ea4iln-debug/CHISPAS-EA4ILN/ROADMAP.md

# Hoja de ruta de Chispas

Estado a 16 de octubre de 2026, con el firmware **v1.20** (final; la v1.10 fue la primera final). Lo marcado ✅ está hecho y probado en placa.

## 1. Pruebas pendientes

Funciones que ya están en el firmware pero falta comprobar en la placa.

| | Prueba | Cómo |
|---|---|---|
| ✅ | Reinicio de la OTA si la descarga no avanza en 30 s | 16 oct 2026, placa 2: internet cortado al 40 %, reinicio a los 30 s en la v1.10 |
| ⬜ | Tendencia del BME280 y aviso de tormenta | Placa 1 con varias horas de datos |
| ✅ | Parques POTA cercanos con fijo del GPS | 15 oct 2026, en la calle con la posición del GPS |
| ✅ | Pila del motor CW tras Duo | 15 oct 2026 (v1.10): 3148 bytes libres de 4096 |
| ✅ | QSO LIBRE en los dos sentidos | 15 oct 2026, placa perforada y protoboard |
| ✅ | Batería calibrada con polímetro | 15 oct 2026, placa perforada: factor único 4,985 para todas |
| ~~⬜~~ | ~~Consumo del GPS dormido~~ | Descartado el 16 oct 2026: despreciable, no se mide |
| ~~⬜~~ | ~~Nube de tormenta del salvapantallas~~ | Descartado el 16 oct 2026: en Badajoz hay pocas tormentas (la cara de auriculares, vista) |
| ⬜ | Salvapantallas y brillo (v1.05b) | Cara a los 15 s en Inicio, PROP, POTA, SOL y CONF (no en CW, LoRa, TRX ni con el portal/QR); brillo tenue al minuto en todas |
| ✅ | Control del amplificador (SD en GPIO38) | Placa 1, 12 oct 2026 (v1.04b por OTA): suena en CW, LoRa, TRX y el pitido de TONO; calla en el resto |
| ✅ | Estabilidad tras muchas horas | Placa 2, noche del 12 oct 2026: 8 h en POTA (233 consultas HTTPS); heap libre ±150 B, mínimo estable tras la 1.ª hora, mayor bloque y pilas sin cambios |
| ✅ | OTA del binario sin encoder a la v1.02b y a la v1.03b | Placa 2, 12 oct 2026 (la variante se quitó en la 1.20) |
| ✅ | Batería después del decodificador | Placa 2, 12 oct 2026: la tensión se sigue leyendo bien tras DECODIFICAR y QSO |
| ✅ | QSO del TRX con emisora real | 12 oct 2026: manipular y decodificar en la misma sesión, sin descodificar lo propio |
| ✅ | Keyer iámbico | 12 oct 2026: apretón en modo A y B, y textos largos |
| ✅ | Xiegu X6200 con KEY | 12 oct 2026, en llave recta con el puente R-T de J4: TUNE, palas y memorias |
| ✅ | Dormir y despertar en la placa 1 | 12 oct 2026 (antes solo en la placa 2) |
| ✅ | Consumo en deep sleep | Despreciable, medido en µA (12 oct 2026) |

## 2. Hardware

### Montado
- **GPS NEO-6M**: ✅ montado y probado el 13 oct 2026 (TX a GPIO47, RX a GPIO39). Apagarlo cuando no se usa:
  1. ✅ **Por software (funciona; consumo dormido despreciable, no se mide):** cable de GPIO39 (J3-10) al RX del GPS y órdenes UBX (`UBX-RXM-PMREQ` para
     dormir; si no despierta bien, `UBX-CFG-RST` con GNSS stop/start). Medir con el polímetro en serie con el VCC del
     GPS: si dormido baja de ~0,5 mA, no hace falta transistor.
  2. ~~Interruptor en el positivo~~ (**descartado el 13 oct 2026**; GPIO3, BAJO = encendido): AO3401A, o sus equivalentes en SOT-23 IRLML6401,
     Si2301 o DMG2305UX, con R8 de 100 kΩ; o un PNP de patillas (BC327 o BC557) con 1 kΩ en la base y 10 kΩ de base a
     emisor, que resta ~0,1–0,2 V. No valen el BSS84 ni el BS250 (no conducen bien con 3,3 V).

### Por comprar
- Divisor de minijack 1 → 2, para seguir oyendo la emisora con el decodificador conectado.

### Opcional
- **Trafo de aislamiento 600:600**, solo si aparece zumbido por lazo de masa con la emisora.
- **C3 (10–100 nF) de GPIO6 a GND**, solo si el decodificador da ruido o letras falsas (por ejemplo, al transmitir
  con potencia): filtra la RF y el ruido de alta frecuencia y estabiliza la lectura del ADC.
- **Detección de USB y de carga** (aparcada el 14 oct 2026): sin USB el pin 5V da 1,3 V, no 0 V, y con 47k/68k a
  GPIO33 quedan 0,7 V, poco margen. Si se retoma, GPIO3 con ADC (ver NOTAS).

### PCB propia (en curso)
- ✅ Placa perforada montada y probada (15 oct 2026).
- ✅ PCB en KiCad 10 (90 × 60 mm, SMD montado por JLCPCB): esquema, rutado y serigrafía; pedidos a JLCPCB (5 placas)
  y LCSC hechos el 15 oct 2026.
- ⬜ Recibir, montar y probar (comprobar el encaje del potenciómetro CTR comprado para R7, en lugar del ALPS
  sin stock; el diseño y la BOM siguen con el ALPS).

## 3. Desarrollo del firmware

### Con el hardware nuevo
- ✅ **GPS en el firmware (hecho y probado en la placa 1 el 13 oct 2026**; detalle en NOTAS, "Funciones"; añadido:
  CONFIG > HORA (UTC/LOCAL) y RELOJ (fuente GPS > WIFI > MANUAL y hora a mano). Diseño con el que se hizo:
  - **Estados:** AUSENTE (sin módulo: todo como hoy) · DORMIDO (por defecto) · BUSCANDO · CON FIJO. Se despierta solo
    cuando algo necesita un dato y vuelve a dormir al tenerlo; mientras, se usa el último dato bueno.
  - **Cuándo se despierta:** al arrancar o despertar Chispas (antes un 0xFF por si quedó dormido de la sesión anterior:
    sigue alimentado aunque el ESP32 se reinicie; tope ~5 min sin fijo); **cada 10 min**, con la muestra de presión del
    BME280 (tope ~60 s); **mientras se ve STATUS > GPS**; antes del deep sleep, PMREQ y GPIO39 retenido en ALTO
    (reposo de la UART). Consumo medio estimado ~2 mA (razonado).
  - **Hora:** UTC del GPS en el reloj del sistema; SOL ya no enciende el WiFi si hay hora del GPS (NTP sin GPS).
  - **Locator:** CONFIG > LOCATOR con opción **AUTO (GPS)** / manual; el manual queda de respaldo. Guardar en NVS solo si
    cambia la cuadrícula.
  - **Altitud y BME280:** QNH recalibrado con la media de la altitud del GPS; historial de presión **corregido a nivel
    del mar** con la altitud de cada muestra (sin falsos "TORM!" al subir: 3 hPa son solo ~25 m).
  - **STATUS > GPS** (página nueva): estado, satélites en uso, lat/lon, altitud, HDOP, locator y antigüedad del dato;
    "GPS NO DETECTADO" sin módulo.
- ✅ **Parques POTA cercanos (hecho el 14 oct 2026, en POTA > VER PARQUES):** lista de parques de España descargada de pota.app a la placa con WiFi
  (LittleFS, partición de 1,5 MB reservada; **no** en el repositorio) y búsqueda sin conexión: los más cercanos con
  distancia y rumbo en la pantalla POTA; "ACTUALIZAR PARQUES" con WiFi. Antes: leer las condiciones de uso de los datos
  de POTA y averiguar la URL de la lista o de la búsqueda por zona.
- **BME280, lo que queda** (lo básico está hecho en la v1.03b):
  - Comprobar la tendencia y el aviso de tormenta con datos de varias horas.
  - ✅ Con el GPS (v1.07b): QNH calibrado con la altitud del GPS e historial de presión a nivel del mar (sin falsos
    avisos de tormenta al subir a un monte).
  - Por decidir: mantener el historial de presión con Chispas dormido (despertar cada 15 min).

### Ideas decididas
- ✅ **POTA sin conexión** (14 oct 2026): lista de parques de España en LittleFS y los más cercanos en POTA > VER
  PARQUES. Queda, si se quiere, buscar un parque por referencia.
- ✅ **Autospot POTA** (18 oct 2026): VER PARQUES > pulsar > ficha > enviar, con aviso a los 25 min para renovarlo.
  Queda, si se quiere, la **cola**: guardar el spot sin cobertura y enviarlo en cuanto haya WiFi (ojo: un spot
  atrasado puede engañar a los cazadores). La frecuencia, sin CAT, se mete a mano (ver CAT abajo).
- ✅ **Batería en `[DIAG]`** (16 oct 2026): `| BAT 4.17V 100%` al final de la línea, para medir la autonomía con un registro.
- ✅ **Koch con indicativos y QSO POTA** (16 oct 2026): ajuste TEXTO del Koch.
- ✅ **Ritmo de la manipulación** (16 oct 2026): TX LIBRE > menu > RITMO. Falta probarlo con las palas.
- **CLUSTER** (23 oct 2026, en diseño): pantalla 10 con spots por telnet (RBN por defecto, URE y otros), lista,
  ficha, "a SU" y ¿QUIÉN ME OYE? (fase 1); alertas (fase 2); enviar spots (fase 3). Nodos y decisiones en NOTAS: "CLUSTER".

### Por decidir
- ✅ **Batería llena = 100 %** (16 oct 2026): 4,15 V o más cuenta como 100 %.
- ~~**SOTA**~~ (**descartado**): las condiciones de su API exigen aprobación previa para software generado con IA;
  no se programa el cliente.

### A estudiar (no prioritario)
- **Audio I2S:** tono senoidal con rampas (sin clics) y volumen por software con un módulo DAC + amplificador I2S
  (p. ej. MAX98357A, 3 GPIO). Sustituiría al PAM8302A y obligaría a rehacer la salida de auriculares.
- **GPS ATGM336H** en lugar del NEO-6M: más pequeño, más barato y de menor consumo (GPS + BeiDou), con la misma
  conexión (UART a 9600 bd, NMEA). Por ahora se sigue con el NEO-6M.
- **Despertar y pitar a distancia ("buscar Chispas")** (16 oct 2026, aparcado): el deep sleep apaga la radio, así
  que el BLE no puede despertar. Opciones: light sleep con BLE anunciándose (~1–3 mA dormido; NimBLE; ajuste
  apagado por defecto; Web Bluetooth desde la web en Chrome, no en iPhone), deep sleep con despertar periódico, o
  despertar por LoRa (`startReceiveDutyCycle`, DIO1 = GPIO14 RTC; mucho menos consumo, pero solo desde otro
  Chispas). Primer paso: medir el consumo en light sleep con BLE en una prueba aparte en `pruebas/`.
- **Navegación en el campo con el GPS** (18 oct 2026, aparcado hasta una PCB nueva): marcar el punto de partida, ir
  a un parque POTA (rumbo y distancia), grabar el recorrido en LittleFS (12 bytes por punto) y volver en línea recta
  o desandando. Aparcado porque **sin brújula** el NEO-6M solo da el rumbo de marcha (inútil parado o a menos de
  ~3 km/h); hace falta magnetómetro y acelerómetro (compensar la inclinación) en una futura versión de la PCB, p. ej.
  en Wire1 con el BME280. Consumo estimado: GPS siempre despierto, ~70 mA, unas 40 h con 3000 mAh (frente a ~100 h).
- **CAT con el transceptor** (18 oct 2026, aparcado hasta una PCB nueva): leer la frecuencia y el modo (para el
  autospot POTA y TRX), QSY a un spot con un clic. Radios del usuario: **Icom CI-V** (IC-705, 7300…; un hilo, jack
  de 3,5 mm) y **FT-817/818** (serie TTL a 5 V por ACC, mini-DIN 8), y quizá otra por concretar. Un conector CAT de
  3 hilos (TX, RX, GND) en el UART2 con dos pines libres (33, 34, 40 o 3): CI-V uniendo TX y RX con diodo y pull-up,
  FT-817 con divisor de 5 a 3,3 V en la RX; tipo por puente o en CONF > CAT (NO / ICOM / FT-817, dirección CI-V,
  velocidad). Software: un `cat.inc` (~200 líneas por protocolo; CI-V `0x03`, FT-817 trama de 5 bytes). Radios
  **solo USB** (FT-891, QMX…): no viables, el USB del S3 (GPIO19/20) lo usa el encoder. Con la PCB actual se puede
  probar con cables a los pines libres.

### Instalación y estructura del firmware (ideas)
- ~~**Web de instalación por USB**~~ **Hecha el 16 oct 2026**: https://ea4iln-debug.github.io/CHISPAS-EA4ILN/
  (ESP Web Tools en GitHub Pages; una GitHub Action copia y parte el firmware de la última release final para
  conservar la NVS). Detalle en `docs/NOTAS.md` ("Releases y OTA").
- **Firmware modular**, con la opción de **un solo binario con todo y módulos activados en el aparato** (la app ocupa
  bastante menos de la mitad de sus 3,2 MB): autodetección donde se pueda (el BME280 ya se detecta; el GPS, si llegan
  frases NMEA) y una pantalla **CONF > HARDWARE** (o un asistente al primer arranque) para lo que no se detecta
  (encoder, amplificador, KEY…). Un solo binario simplifica la OTA (la variante sin encoder ya se quitó en la 1.20). La
  web podría llevar casillas de hardware (generando la NVS en el navegador, o mejor preguntándolo al primer arranque).
  Descartado: compilar a la carta en un servidor (lento, necesita un token o un servidor propio) y precompilar todas
  las combinaciones (2^N binarios).
- **Partir `main.cpp` en módulos** (keyer, Koch, Echo, LoRa, TRX, decodificador, WiFi, BME, GPS…) con su `.h`/`.cpp`
  y una interfaz común de disponible/activado; por fases, sin cambiar el comportamiento, compilando y probando en
  placa en cada paso. Prepara el Lite (LoRa o ESP-NOW como transporte intercambiable). Paso previo hecho el 13 oct
  2026: `main.cpp` ya está repartido en `src/parts/*.inc` (mismo código, una sola unidad de compilación).

## Versiones de Chispas (ideas)

### Chispas Pro (el actual, Heltec V3)
- **Bluetooth (BLE)**: el ESP32-S3 solo tiene BLE 5 (nada de auriculares Bluetooth ni puerto serie clásico).
  - **Teclado Bluetooth (HID):** lo manipulado con las palas se escribe en el móvil o el PC; con las teclas que espera
    **VBand**, practicar por internet con las palas, sin cables.
  - **Configuración y estadísticas desde el móvil** con una página **Web Bluetooth** (Chrome, sin instalar nada):
    memorias, indicativo y locator; estadísticas de Koch y Echo con gráficas y exportación.
  - **Hora y posición del móvil** para SOL y la línea gris en el campo, sin WiFi ni GPS.
  - **El móvil como pasarela** en una salida POTA: spots y propagación hacia Chispas, y publicar el spot propio.
  - **Teclado CW desde el móvil** (diseñado el 13 oct 2026, por decidir): servicio **Nordic UART (NUS)** por BLE,
    usable con apps ya existentes (*Serial Bluetooth Terminal* en Android; *Bluefruit Connect* o *nRF Connect*, también
    en iPhone). Opción BLUETOOTH en CONFIG, nombre `Chispas-XXXX` e indicador **BT** en la cabecera. Lo escrito sale
    según la pantalla: por **KEY** en TRX > OPERAR/QSO (a los wpm de TRX, como una memoria), por **LoRa** en QSO LIBRE,
    y por el **altavoz** en TX LIBRE; en el resto se ignora. `{MI}`, `{SU}` y `{WX}`; cola de ~200 caracteres; las
    palas o `/stop` lo cortan; órdenes opcionales (`/wpm 25`, `/su EA1ABC`, `/m1`). Chispas devuelve al móvil lo
    enviado y lo descodificado en TRX > QSO (registro del QSO). Solo transmite por KEY donde ya lo hace y con el corte
    de 10 s. Trabajo: NimBLE + NUS (~200–300 líneas), cola hacia el motor CW (trozos de 64) o QSO LIBRE; antes, medir
    la memoria con BLE y WiFi a la vez. Empezar por TRX y TX LIBRE.
  - Coste: unos 50–100 KB de RAM (hay ~249 KB libres), algo de flash y de consumo; mejor NimBLE que Bluedroid
    (comprobar con el core 2.0.17 y el S3).
- **Carcasa impresa en 3D con diseño propio:** OpenSCAD paramétrico a partir del plano de la placa perforada
  (`docs/gen_placa.py`); logo de chispa, «CHISPAS EA4ILN» en relieve, rejilla del altavoz con «73» en Morse y rótulos
  grabados junto a los jacks. Faltan las medidas de batería, altavoz, jacks, encoder, RV1, GPS, interruptor y SMA, el
  uso (mesa, mano o colgado) y el estilo. Probar por piezas antes de imprimir la caja entera.

### Chispas Ultimate
- **Palas táctiles integradas** (como el Morserino-32): GPIO4 y GPIO5 son táctiles en el S3; el jack de palas pasaría
  a GPIO39/40. Electrodos: tornillos de latón o inoxidable, chapa, trozos de PCB dorada, cinta de cobre por dentro de
  la pared o filamento conductor; 470 Ω–2 kΩ en serie. Firmware: `touchRead()` en la tarea del keyer, calibración al
  arrancar y sensibilidad en CONF. Pegas: humedad, guantes, sensibilidad según se sujete. Prueba previa barata: un
  programa en `pruebas/` con dos tornillos o cinta de cobre.

### Chispas Lite
Un ESP32 cualquiera con OLED, encoder, palas y tono, **sin LoRa**. Hace casi todo lo del Pro; lo que pierde es el
alcance de la radio.
- **Igual que en el Pro** (no dependen de la LoRa): Koch (los dos modos de corrección, estadísticas y refuerzo), Echo,
  TX LIBRE (keyer A/B); PROP, POTA y SOL con NTP; webconf con QR; OTA (con sus propios binarios); CONF, STATUS,
  depuración, salvapantallas y dormir; TRX con KEY por PC817, memorias y TUNE.
- **Duo y QSO por ESP-NOW** (el WiFi del chip, sin router), con las mismas tramas: 50–200 m (más con línea de vista y
  el modo de largo alcance) frente a los kilómetros de la LoRa. **El Pro también tiene WiFi: podría hablar ESP-NOW y
  practicar con un Lite.** ESP-NOW y WiFi comparten radio y canal: durante Duo o QSO no se usa el WiFi (como ahora).
- **Según la placa:**
  - Decodificador: el ADC por DMA está escrito para el S3; en un ESP32 clásico o un C3 hay que adaptar la captura
    (el Goertzel y el resto sirven).
  - Batería: muchas placas no traen cargador ni divisor; añadir un TP4056 y un divisor.
  - Bluetooth: un ESP32 **clásico** tiene Bluetooth clásico además de BLE; se podría estudiar sacar el tono a
    auriculares Bluetooth (A2DP), que el S3 no puede. Experimental.
  - BME280, GPS y amplificador: opcionales, igual que en el Pro, si hay pines.
- **No tendría:** LoRa (ni largo alcance ni Duo/QSO por radio con un Pro lejano) ni OLED integrada, salvo placa que la
  traiga.
- **Coste:** la Heltec V3 cuesta unos 20–25 €; un ESP32 con OLED, encoder y cargador, unos 12–15 €. El ahorro está más
  en lo que se deja fuera (LoRa, GPS, BME280, amplificador) que en la placa: el Lite tiene sentido como versión más
  sencilla y barata para clubes o alumnos.
- **Firmware:** el mismo `main.cpp` con un entorno `chispas_lite` (como el antiguo `heltec_sin_encoder`); lo principal, separar
  la capa de transporte (LoRa / ESP-NOW), ya decidida como intercambiable.

## 4. Documentación y publicación
- ✅ GPS en el esquema (montado) y en el README; release v1.07b publicada (14 oct 2026).
- ✅ Capturas nuevas: CONFIG, STATUS > GPS, PONER HORA, POTA y VER PARQUES.
- ✅ Releases v1.08b y v1.09b (14 oct 2026), **v1.10** (15 oct 2026, primera final; última con binario sin encoder)
  y **v1.20** (16 oct 2026, solo con encoder).

## Orden propuesto
1. **Sin piezas:** tendencia del BME280 con varias horas de datos; salvapantallas y brillo (v1.05b).
2. **Al llegar la PCB:** montarla y probarla.
3. **Después:** cola de spots POTA y, si se quiere, Bluetooth (teclado CW desde el móvil).

## Hecho
- ✅ Entrenador Koch estilo LCWO con corrección por letra o por total, Echo y TX libre (keyer iámbico A/B).
- ✅ Estadísticas por carácter y por lección (Koch y Echo), y refuerzo de las letras con más errores.
- ✅ Práctica en pareja y QSO libre por LoRa.
- ✅ Tono por altavoz (amplificador PAM8302A) y auriculares, con volumen; SD del amplificador en GPIO38 desde la
  v1.04b. El buzzer piezo del principio sonaba demasiado bajo y se descartó.
- ✅ Salida KEY aislada con tune y memorias (probada con una uSDR).
- ✅ Decodificador CW del audio de la emisora (probado con audio Morse real).
- ✅ Propagación, spots POTA, sol y línea gris.
- ✅ Configuración en el aparato, página de estado y depuración desde el menú.
- ✅ Sensor ambiental BME280 (v1.03b): página AMBIENTE en SOL, tendencia y aviso de tormenta, altitud barométrica
  calibrable y macro {WX}.
- ✅ Actualización por WiFi desde las releases de GitHub.
- ✅ GPS (13 oct 2026): hora, locator y altitud automáticos; hora con fuente (GPS > WIFI > MANUAL) y puesta a mano.
- ✅ Parques POTA cercanos sin conexión (14 oct 2026): lista de España en LittleFS, distancia y rumbo.
- ✅ Consumo en reposo despreciable.
- ✅ Placa perforada montada y probada (15 oct 2026).
