ea4iln-debug/CHISPAS-EA4ILN/docs/img/chispas_campo.jpg

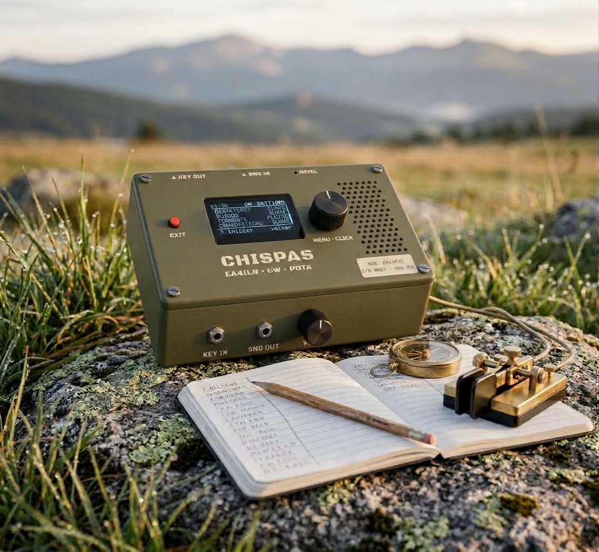
docs/img/chispas_campo.jpg
