ea4iln-debug/CHISPAS-EA4ILN/docs/img/cluster_oyen_ficha.png

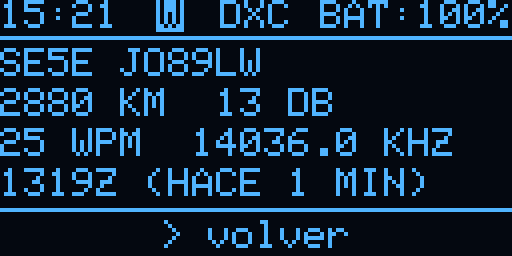
docs/img/cluster_oyen_ficha.png
