ea4iln-debug/CHISPAS-EA4ILN/docs/img/echo_totales.png

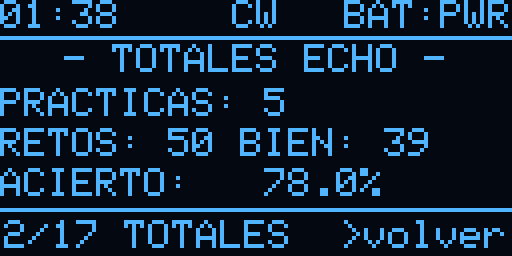
docs/img/echo_totales.png
