ea4iln-debug/CHISPAS-EA4ILN/docs/img/placa_perforada.jpg

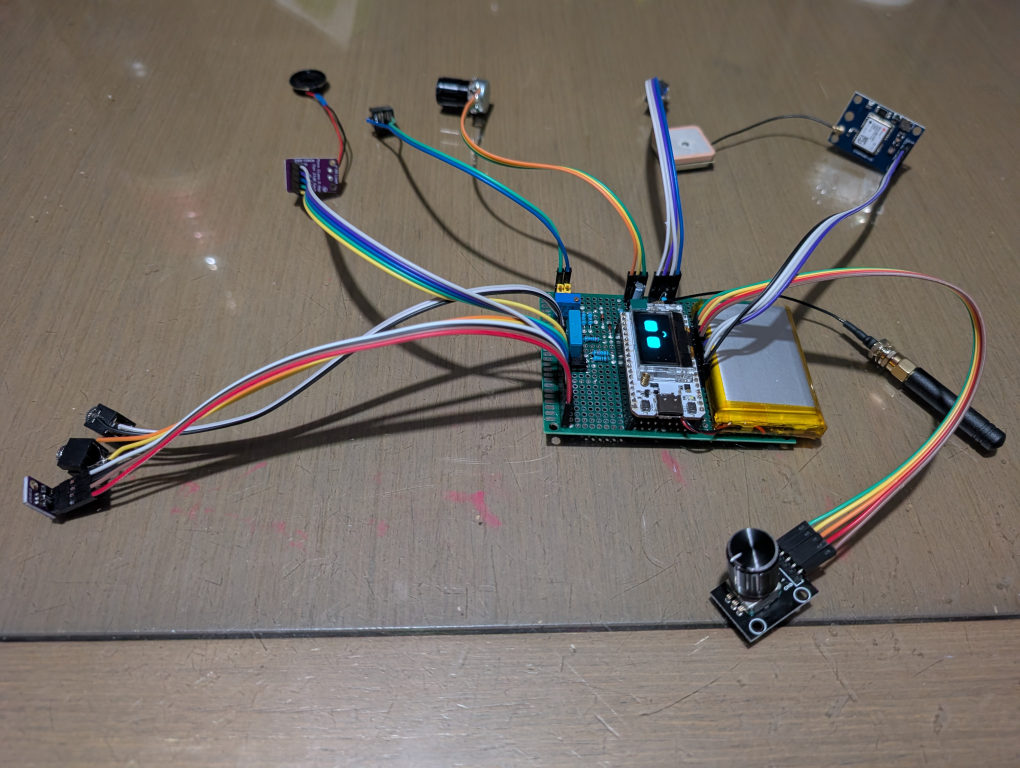
docs/img/placa_perforada.jpg
