ea4iln-debug/CHISPAS-EA4ILN/docs/img/pota_menu_activacion.png

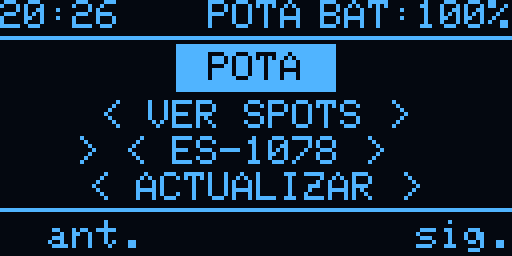
docs/img/pota_menu_activacion.png
