ea4iln-debug/CHISPAS-EA4ILN/docs/img/spot_activacion2.png

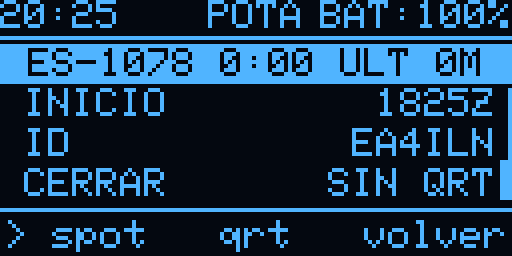
docs/img/spot_activacion2.png
