ea4iln-debug/CHISPAS-EA4ILN/docs/img/spot_ficha2.png

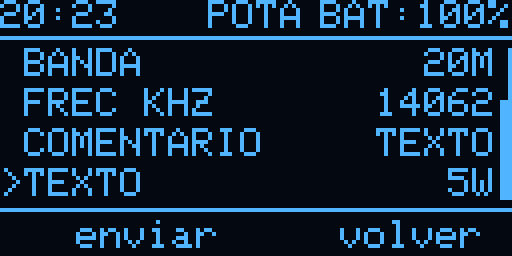
docs/img/spot_ficha2.png
