ea4iln-debug/CHISPAS-EA4ILN/docs/img/spot_qrt.png

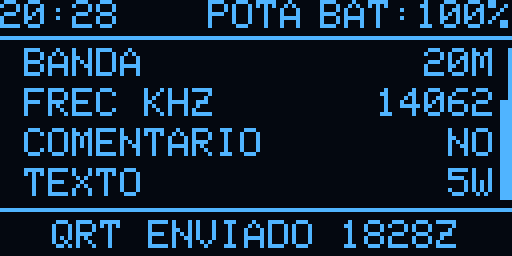
docs/img/spot_qrt.png
