ea4iln-debug/CHISPAS-EA4ILN/web/hardware/esquema_pcb.png

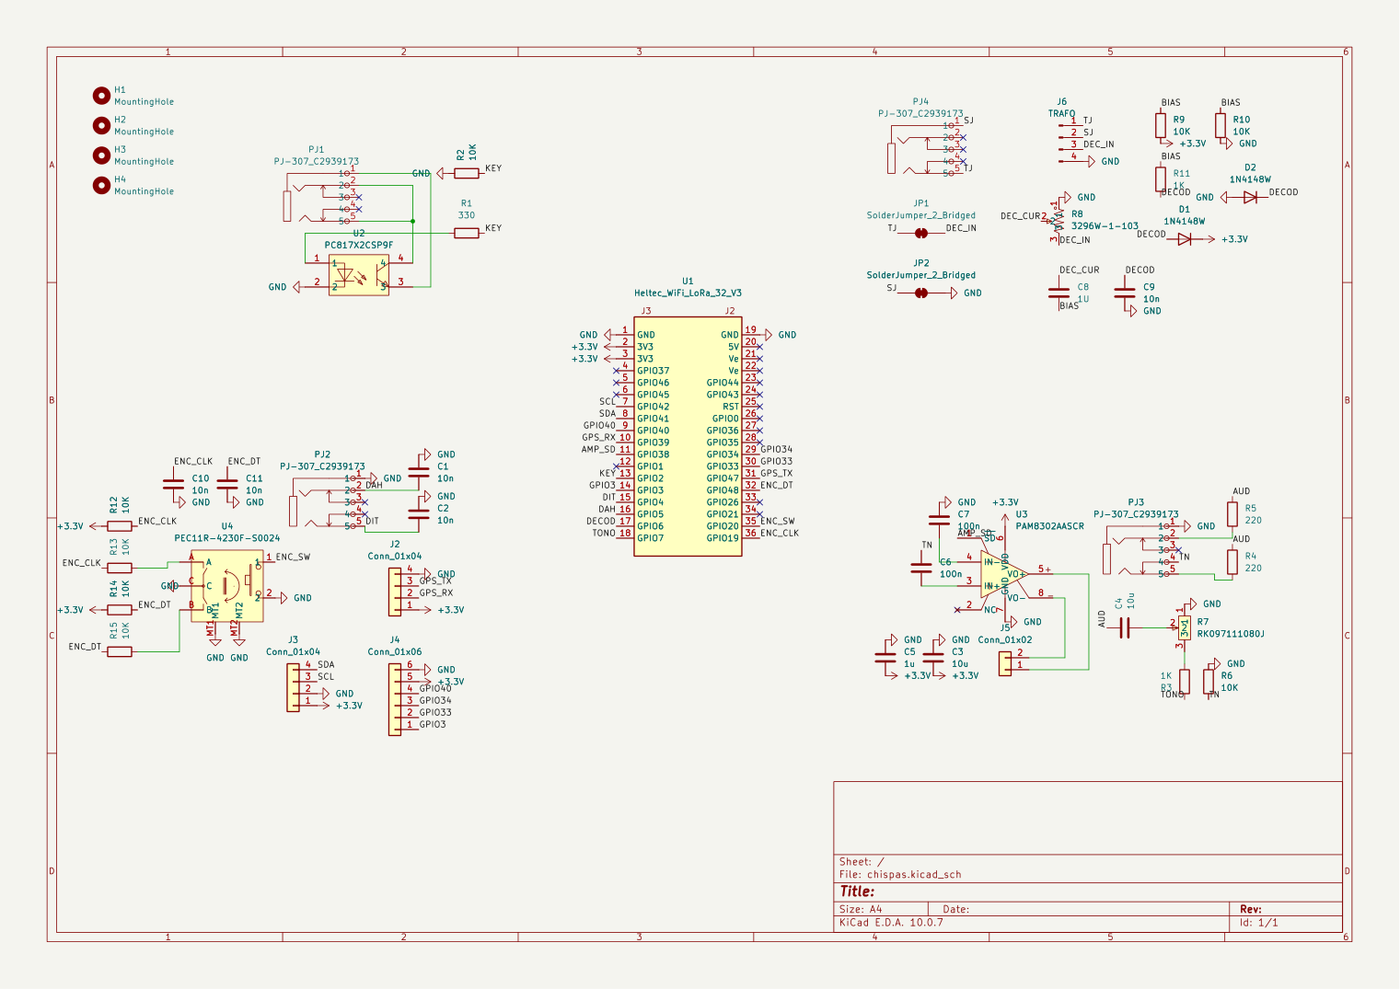
web/hardware/esquema_pcb.png
