ea4iln-debug/CHISPAS-EA4ILN/web/hardware/pcb_3d.png

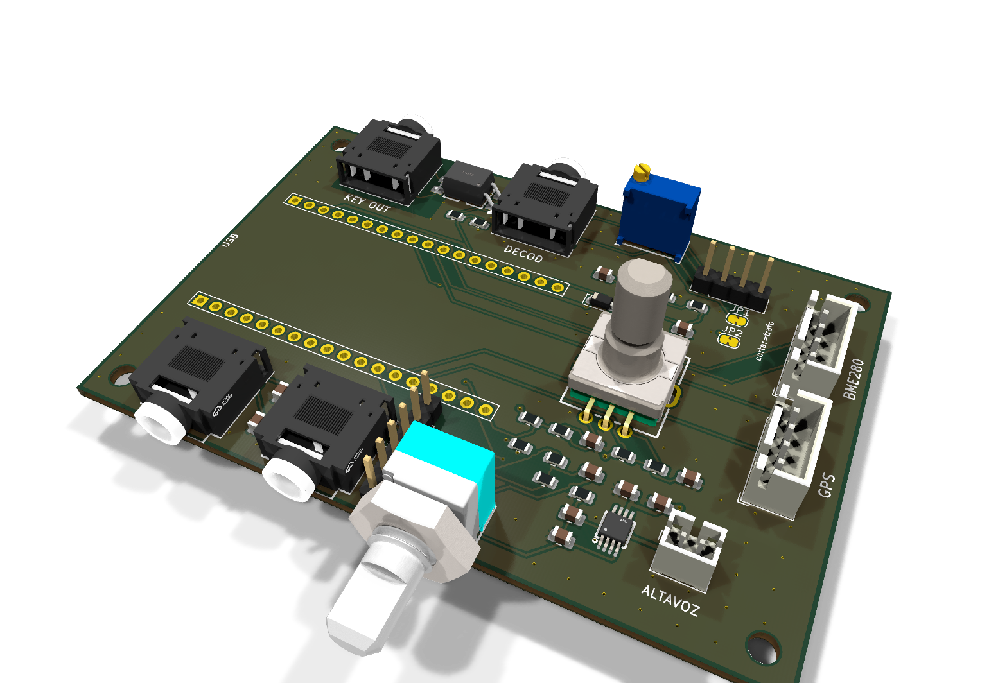
web/hardware/pcb_3d.png
