ea4iln-debug/CHISPAS-EA4ILN/web/hardware/pcb_abajo.png

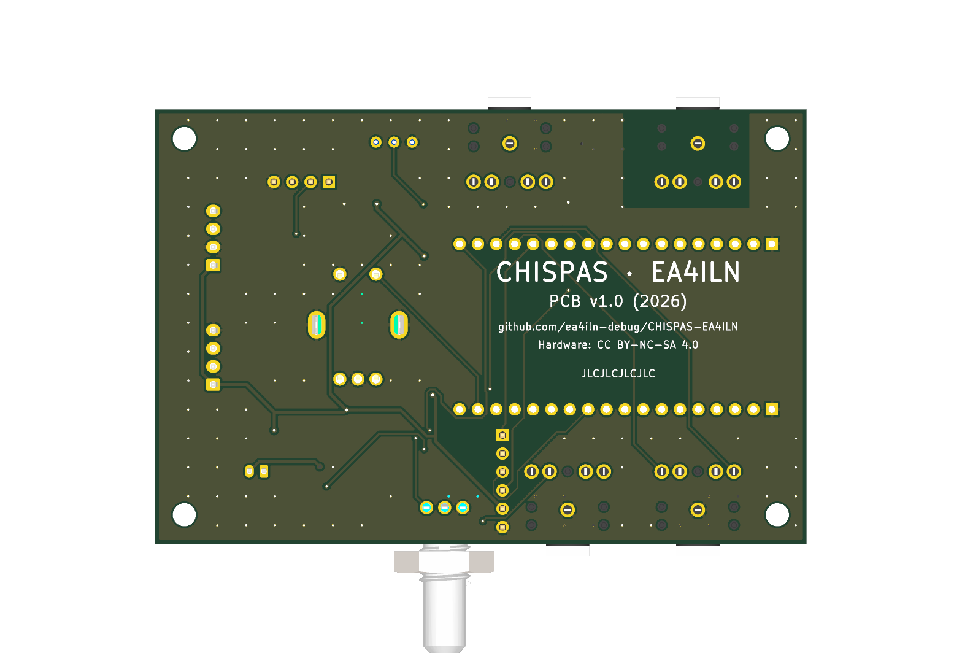
web/hardware/pcb_abajo.png
