ea4iln-debug/CHISPAS-EA4ILN/web/hardware/pcb_arriba.png

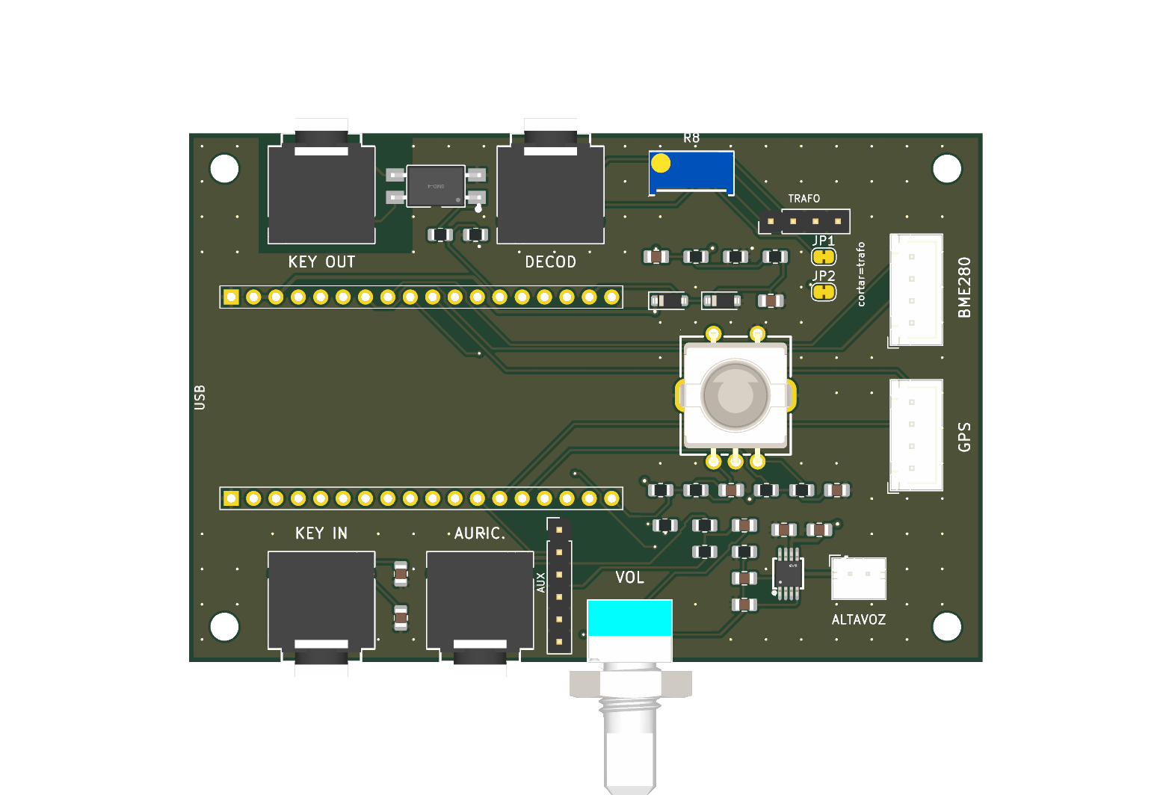
web/hardware/pcb_arriba.png
