ea4iln-debug/CHISPAS-EA4ILN/hardware/fabricacion/chispas_bom.csv

Comment | Designator | Footprint | LCSC
10n | C1,C2,C9,C10,C11 | C_0805_2012Metric | C1710
10u | C3,C4 | C_0805_2012Metric | C15850
1u | C5,C8 | C_0805_2012Metric | C28323
100n | C6,C7 | C_0805_2012Metric | C49678
1N4148W | D1,D2 | D_SOD-123 | C81598
330 | R1 | R_0805_2012Metric | C17630
10K | R2,R6,R9,R10,R12,R13,R14,R15 | R_0805_2012Metric | C17414
1K | R3,R11 | R_0805_2012Metric | C17513
220 | R4,R5 | R_0805_2012Metric | C17557
PC817X2CSP9F | U2 | SMD-4_L4.6-W6.5-P2.54-LS10.2-TL | C66405
PAM8302AASCR | U3 | MSOP-8_L3.0-W3.0-P0.65-LS5.0-BL | C113367
