ea4iln-debug/CHISPAS-EA4ILN/hardware/fabricacion/compra_lcsc.csv

Pieza | Referencias | LCSC | Por placa | Para 5 placas
Conn_01x04 (JST_XH_B4B-XH-A_1x04_P2.50mm_Vertical) | J2,J3 | C144395 | 2 | 10
Conn_01x06 (PinHeader_1x06_P2.54mm_Vertical) | J4 |  | 1 | 5
Conn_01x02 (JST_PH_B2B-PH-K_1x02_P2.00mm_Vertical) | J5 | C131337 | 1 | 5
TRAFO (PinHeader_1x04_P2.54mm_Vertical) | J6 |  | 1 | 5
PJ-307_C2939173 (AUDIO-TH_PJ-307) | PJ1,PJ2,PJ3,PJ4 | C2939173 | 4 | 20
RK097111080J (RES-ADJ-TH_RK097111080J) | R7 | C18213426 | 1 | 5
3296W-1-103 (RES-ADJ-TH_3P-L10.0-W10.0-P2.50-L) | R8 | C118954 | 1 | 5
Heltec_WiFi_LoRa_32_V3 (Heltec_WiFi_LoRa_32_V3) | U1 |  | 1 | 5
PEC11R-4230F-S0024 (SW-TH_PEC11R-4XXXF-SXXXX) | U4 | C7435302 | 1 | 5
Zocalo hembra 1x18 2,54 mm (Heltec) |  | C2905422 | 2 | 10
