ea4iln-debug/CHISPAS-EA4ILN/web/hardware/esquema_pcb.pdf

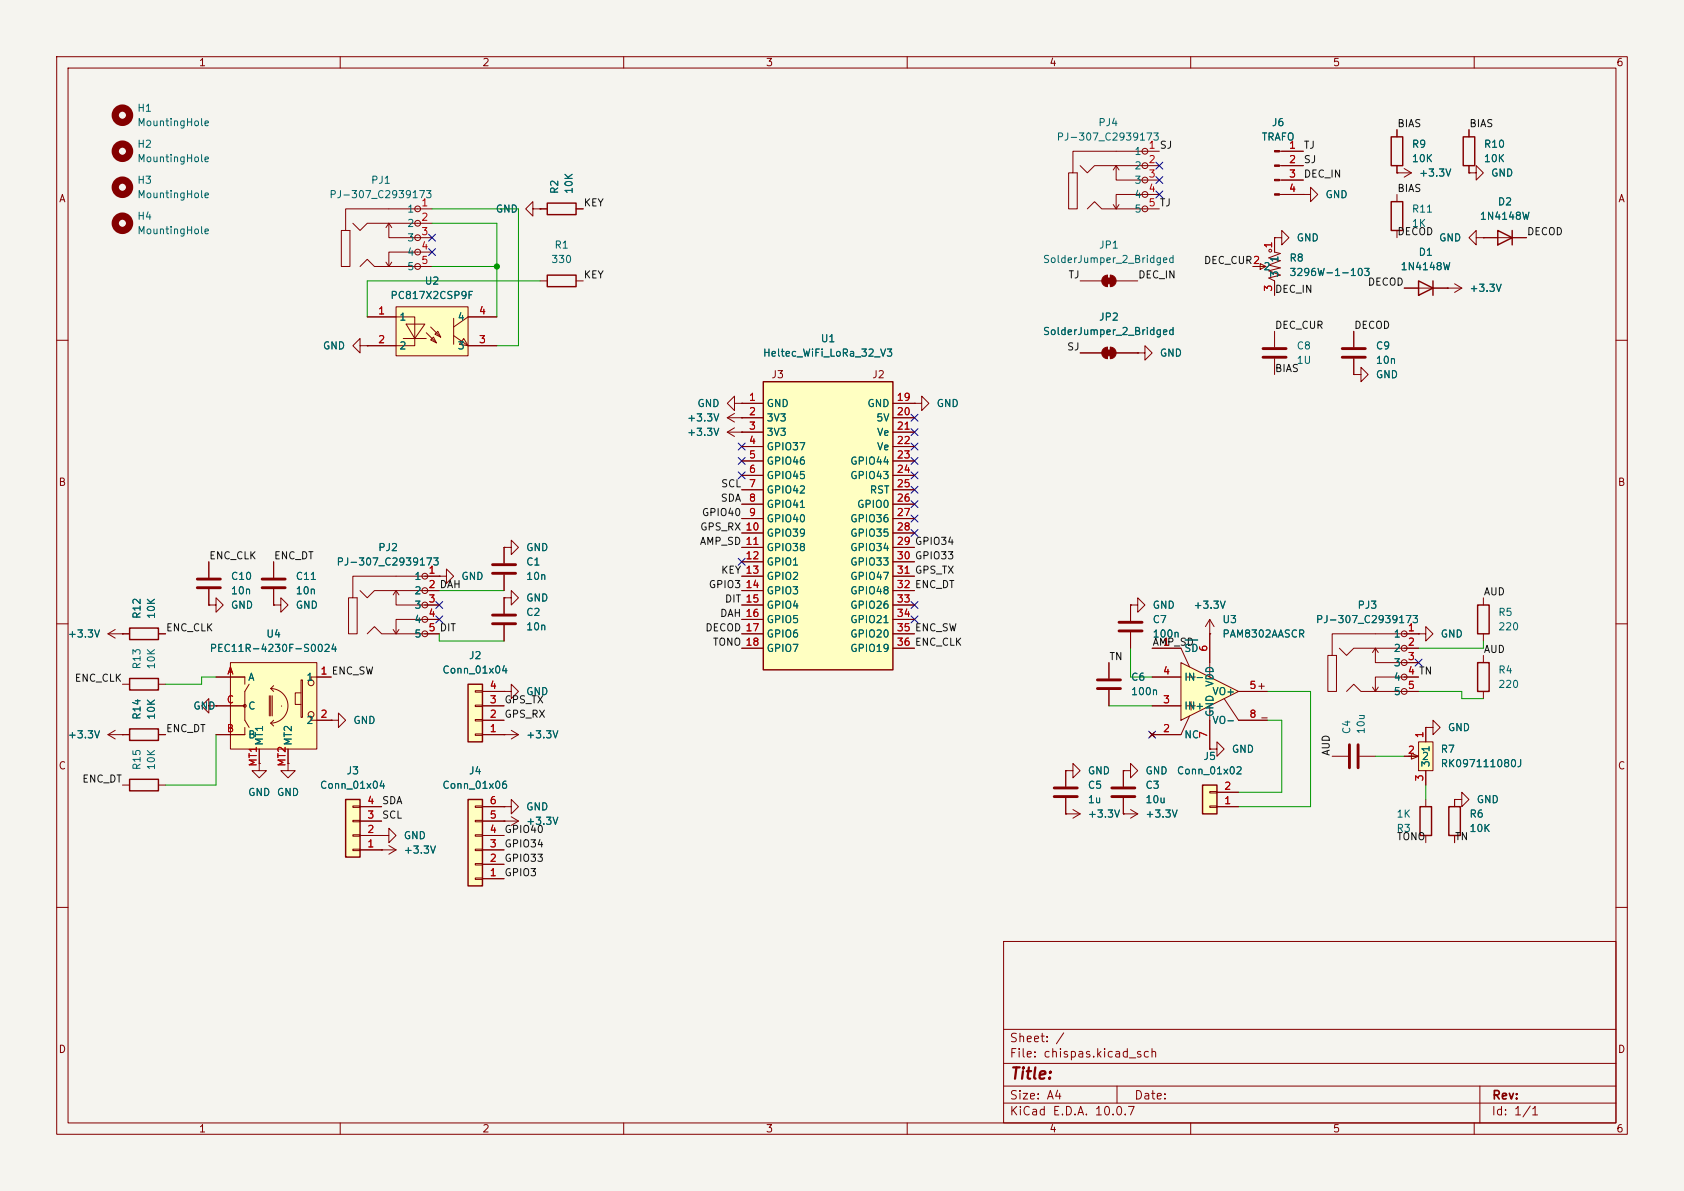
[picture p99: page 1]

Size: A4 | Rev:
KiCad E.D.A. 10.0.7 | Id: 1/1
