ea4iln-debug/CHISPAS-EA4ILN/hardware/chispas.kicad_pcb

## KiCad design hardware/chispas.kicad_pcb (2026-10-20)

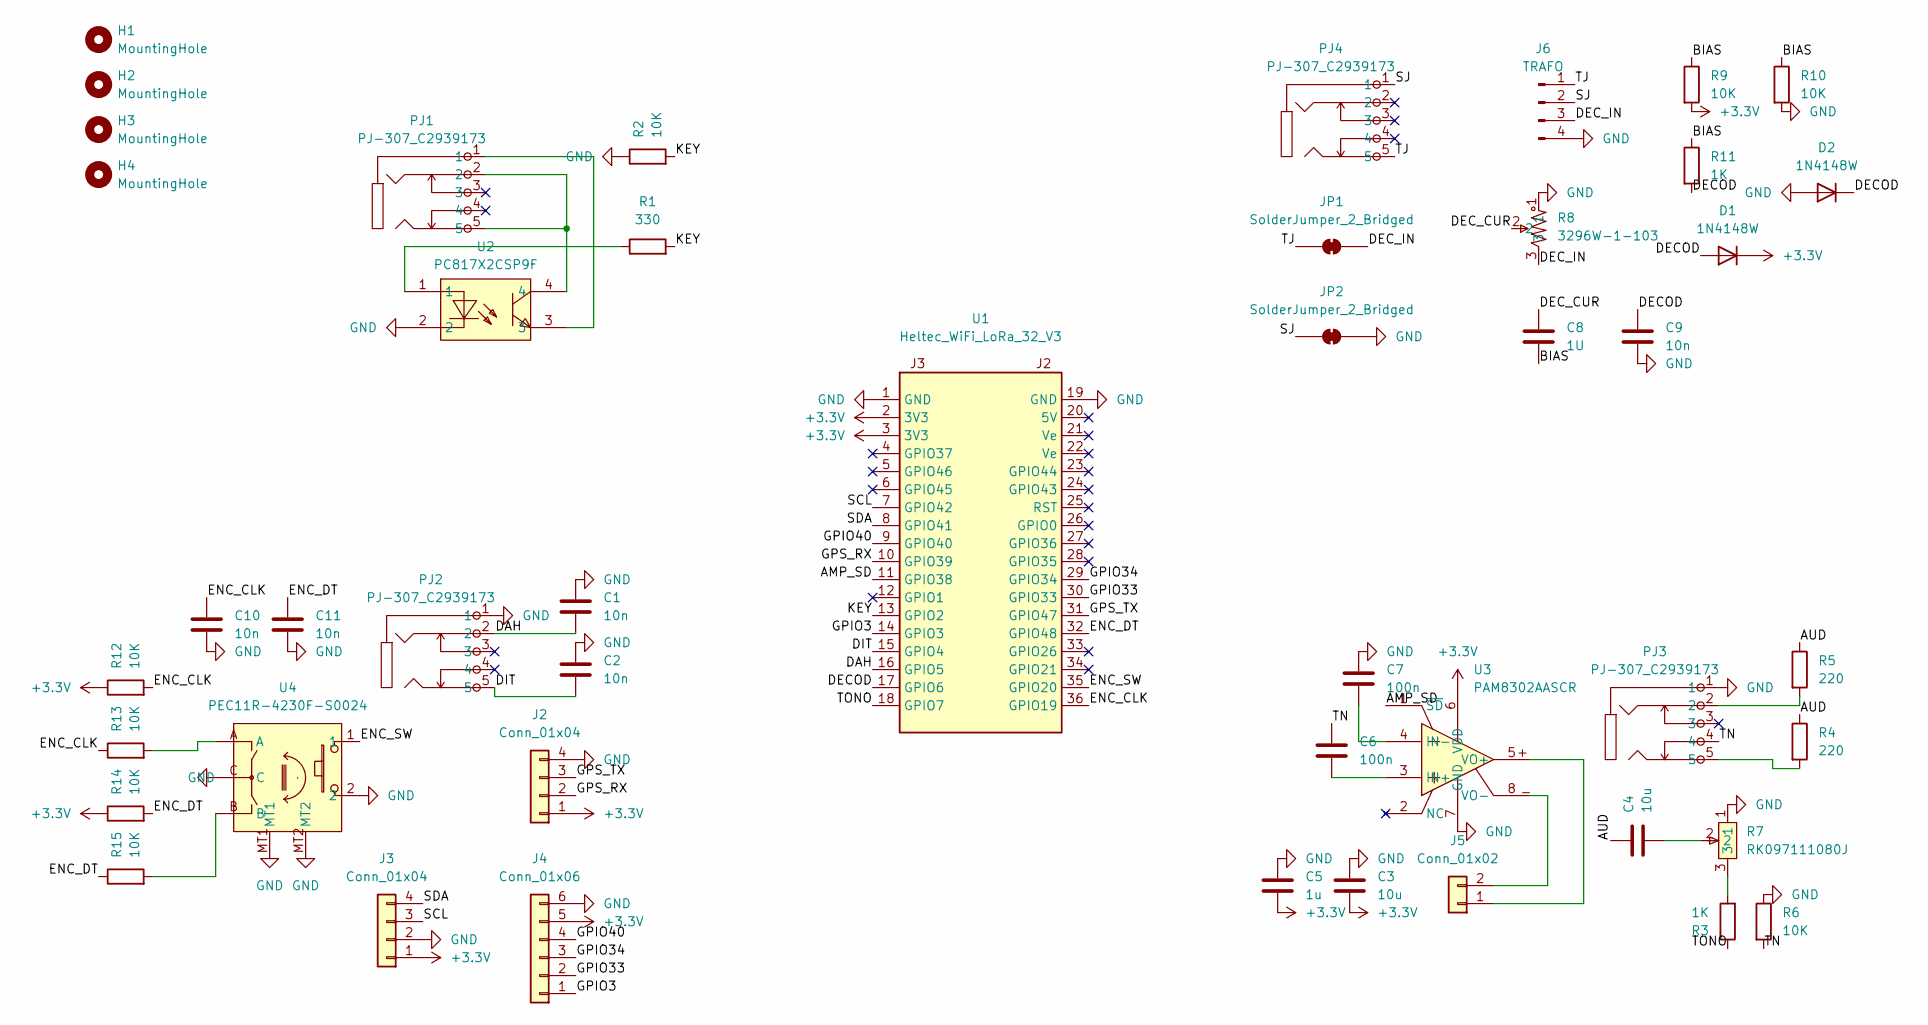
[picture p100: schematic chispas.kicad_sch]

Parts:
C1, C2, C9, C10, C11: 10n; C_0805_2012Metric; LCSC Part C1710
C3, C4: 10u; C_0805_2012Metric; LCSC Part C15850
C5: 1u; C_0805_2012Metric; LCSC Part C28323
C6, C7: 100n; C_0805_2012Metric; LCSC Part C49678
C8: 1U; C_0805_2012Metric; LCSC Part C28323
D1, D2: 1N4148W; D_SOD-123; LCSC Part C81598
H1, H2, H3, H4: MountingHole; MountingHole_3.2mm_M3
J2, J3: Conn_01x04; JST_XH_B4B-XH-A_1x04_P2.50mm_Vertical; LCSC Part C144395
J4: Conn_01x06; PinHeader_1x06_P2.54mm_Vertical
J5: Conn_01x02; JST_PH_B2B-PH-K_1x02_P2.00mm_Vertical; LCSC Part C131337
J6: TRAFO; PinHeader_1x04_P2.54mm_Vertical
JP1, JP2: SolderJumper_2_Bridged; SolderJumper-2_P1.3mm_Bridged_RoundedPad1.0x1.5mm
PJ1, PJ2, PJ3, PJ4: PJ-307_C2939173; AUDIO-TH_PJ-307; MPN PJ-307; LCSC Part C2939173
R1: 330; R_0805_2012Metric; LCSC Part C17630
R2, R6, R9, R10, R12, R13, R14, R15: 10K; R_0805_2012Metric; LCSC Part C17414
R3, R11: 1K; R_0805_2012Metric; LCSC Part C17513
R4, R5: 220; R_0805_2012Metric; LCSC Part C17557
R7: RK097111080J; RES-ADJ-TH_RK097111080J; MPN R09710NS-FB15D7.0-B103-0044; LCSC Part C18213426
R8: 3296W-1-103; RES-ADJ-TH_3P-L10.0-W10.0-P2.50-L; MPN 3296W-1-103; LCSC Part C118954
U1: Heltec_WiFi_LoRa_32_V3
U2: PC817X2CSP9F; SMD-4_L4.6-W6.5-P2.54-LS10.2-TL; MPN PC817X2CSP9F; LCSC Part C66405
U3: PAM8302AASCR; MSOP-8_L3.0-W3.0-P0.65-LS5.0-BL; MPN PAM8302AASCR; LCSC Part C113367
U4: PEC11R-4230F-S0024; SW-TH_PEC11R-4XXXF-SXXXX; MPN PEC11R-4230F-S0024; LCSC Part C7435302

Connections:
+3.3V: C3.2, C5.2, D1.1 (K), J2.1, J3.1, J4.5, R9.2, R12.1, R14.1, U1.2 (3V3), U1.3 (3V3), U3.6 (VDD)
/AMP_SD: U1.11 (GPIO38), U3.1 (~SD)
/AUD: C4.1, R4.1, R5.1
/BIAS: C8.2, R9.1, R10.1, R11.1
/DAH: C1.2, PJ2.2, U1.16 (GPIO5)
/DECOD: C9.1, D1.2 (A), D2.1 (K), R11.2, U1.17 (GPIO6)
/DEC_CUR: C8.1, R8.2
/DEC_IN: J6.3, JP1.2 (B), R8.3
/DIT: C2.2, PJ2.5, U1.15 (GPIO4)
/ENC_CLK: C10.1, R12.2, R13.1, U1.36 (GPIO19)
/ENC_DT: C11.1, R14.2, R15.1, U1.32 (GPIO48)
/ENC_SW: U1.35 (GPIO20), U4.1
/GPIO3: J4.1, U1.14 (GPIO3)
/GPIO33: J4.2, U1.30 (GPIO33)
/GPIO34: J4.3, U1.29 (GPIO34)
/GPIO40: J4.4, U1.9 (GPIO40)
/GPS_RX: J2.2, U1.10 (GPIO39)
/GPS_TX: J2.3, U1.31 (GPIO47)
/KEY: R1.2, R2.2, U1.13 (GPIO2)
/SCL: J3.3, U1.7 (GPIO42)
/SDA: J3.4, U1.8 (GPIO41)
/SJ: J6.2, JP2.1 (A), PJ4.1
/TJ: J6.1, JP1.1 (A), PJ4.5
/TN: C6.1, PJ3.4, R6.2
/TONO: R3.1, U1.18 (GPIO7)
GND: C1.1, C2.1, C3.1, C5.1, C7.1, C9.2, C10.2, C11.2, D2.2 (A), J2.4, J3.2, J4.6, J6.4, JP2.2 (B), PJ2.1, PJ3.1, R2.1, R6.1, R7.1, R8.1, R10.2, U1.1 (GND), U1.19 (GND), U2.2, U3.7 (GND), U4.2, U4.C, U4.MT1, U4.MT2
unnamed: C4.2, R7.2
unnamed: J5.1, U3.5 (VO+)
unnamed: J5.2, U3.8 (VO-)
unnamed: PJ1.1, U2.3
unnamed: PJ1.2, PJ1.5, U2.4
unnamed: PJ3.2, R5.2
unnamed: PJ3.5, R4.2
unnamed: R1.1, U2.1
unnamed: R3.2, R7.3
unnamed: R13.2, U4.A
unnamed: R15.2, U4.B
unnamed: C6.2, U3.3 (IN+)
unnamed: C7.2, U3.4 (IN-)

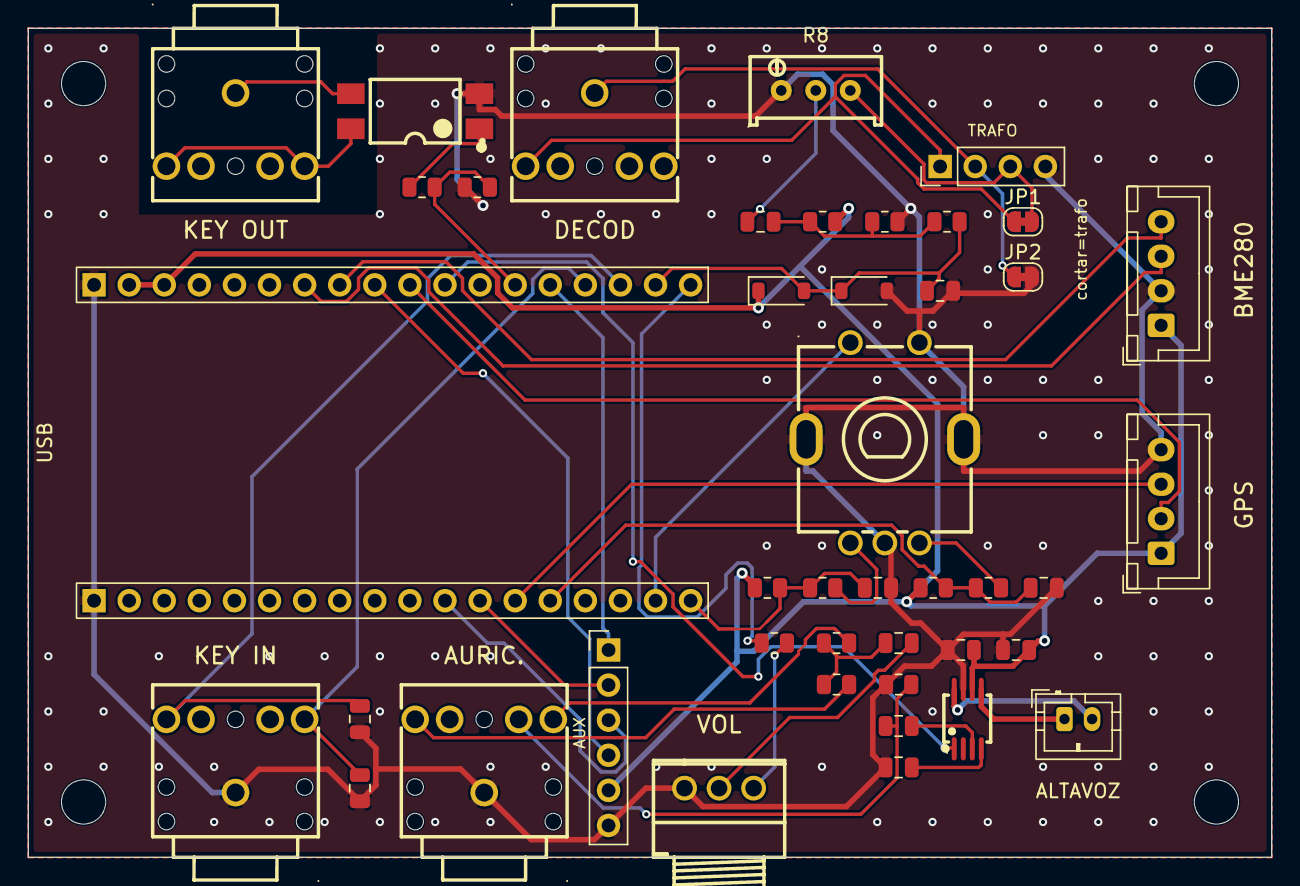
[picture p101: board chispas.kicad_pcb from above]

Board: 2 copper layers, 90.0 x 60.0 mm, 47 parts (0 on the bottom side), 39 nets.
