ea4iln-debug/CHISPAS-EA4ILN/(commit log)

2026-10-08 v0.3d
    - Temporizador entre caracteres, semilla con esp_random(), flag LoRa tras TX, salirModoLoRa() (v0.3c)
    - Boton por eventos (BOTON_CORTA / BOTON_LARGA), sin delay (v0.3d)
    - Fija platform = espressif32 @ 6.13.0 (core Arduino 2.0.17; el 3.x elimina ledcSetup)
    - Anade Claude.md con el contexto del proyecto
2026-10-08 v0.3e: cola de recepcion LoRa
    - Los grupos que llegan mientras suena otro se guardan en una cola circular (8)
    y se reproducen despues, con espacio de palabra entre grupos
    - grupoDuoRecibido se asigna al empezar a sonar
    - salirModoLoRa() vacia la cola
2026-10-08 v0.3f: arreglos de pantalla
    - Estadisticas 3.5: linea de 21 caracteres (cabe el %), contador limitado a 99,
    14 paginas de lecciones (aparece la L40)
    - Signo de apertura en "CONFIRMAR BORRADO" con el 0xA8 de CP437
    - Al volver de P3 a P2 el foco queda en "sig."
2026-10-08 v0.3g: bateria en cache y redibujado por cambios
    - leerBateria() cada 30 s y solo cuando no suena CW; el dibujo usa la cache
    - Se quita el refresco fijo cada 3 s: se redibuja solo si cambia bateria o RSSI
    - La cola Duo redibuja antes de empezar cada grupo
2026-10-08 v0.3h: RSSI en Duo y medida de temporizacion CW
    - RSSI de la ultima trama en la pantalla Duo
    - DEBUG_CW: retraso de cada transicion del LED respecto a lo programado,
    informado por serie al final de cada grupo (Koch y Duo)
    - Claude.md: estado actualizado y pendientes resueltos retirados
2026-10-08 v0.4a: trama LoRa v2 de longitud variable
    - Cabecera de 13 bytes: MM, version|tipo, seq, wpm, indicativo (8)
    - Un byte por caracter Morse con bit centinela (punto 0, raya 1); 0x00 = espacio
    - Hasta 32 caracteres por trama; descarte de duplicados por indicativo y seq
    - Motor Duo: espacio entre palabras y salto de caracteres sin codigo
    - Incompatible con la trama anterior: cargar en las dos placas
2026-10-08 v0.4b: TCXO del SX1262 a 1.8 V
    - radio.begin() con tcxoVoltage 1.8 (Heltec V3, igual que Meshtastic heltec_v3);
    RadioLib 6.6 usa 1.6 V por defecto
    - Revisado: DIO2 como RF switch ya activo en begin(); SPI 9/11/10 correcto
2026-10-08 v0.4c: radio a 868.1 MHz SF7/250 kHz y version en pantalla 1
    - Parametros de radio en #define LORA_*: 868.1 MHz (sub-banda 868.0-868.6),
    SF7, 250 kHz (unos 32 ms de aire por trama frente a 226 ms con SF9/125)
    - FW_VERSION en pantalla 1 y en el mensaje de arranque
    - Claude.md: estado de radio y convencion de version
2026-10-08 v0.4d: Duo a los wpm del emisor y CAD antes de transmitir
    - La cola guarda los wpm de cada grupo y lo reproduce a esa velocidad (5-60; si no, los locales)
    - Antes de transmitir: se procesa la trama pendiente y se escucha el canal (CAD);
    si esta ocupado se recibe la trama de la otra placa y se reintenta (3 veces)
    - Claude.md: pendientes reorganizados (aplazados hasta tener el encoder)
2026-10-08 v0.4e: arreglo de la OLED que a veces quedaba negra tras un reset
    - Tras display.begin() se reenvian bomba de carga (0x8D 0x14) y encendido (0xAF):
    en cerca de la mitad de los reinicios cortos el panel no se iluminaba aunque la
    OLED respondia por I2C y su estado decia encendida
    - Pulso de reset y comprobacion del ACK de la OLED antes de inicializarla;
    sin for(;;) si falla
    - Motivo del reinicio por serie
2026-10-08 v0.5a: WiFi, hora NTP, propagacion y spots POTA
    - Pantalla 5: propagacion de hamqsl.com (SFI, SSN, A, K, rayos X) y hora UTC/local
    - Pantalla 6: spots POTA solo CW, mas recientes primero, 4 por pagina
    - WiFi solo en esas pantallas; red configurable con portal WiFiManager
    - Hora por NTP (CET/CEST) en la cabecera
    - Librerias: WiFiManager 2.0.17, ArduinoJson 7
    - SOTA no incluido (sus condiciones exigen aprobacion para software generado por IA)
2026-10-08 v0.5b: condiciones por banda y pantalla de sol y linea gris
    - Pantalla 5: segunda pagina con la prevision de hamqsl por banda (dia / noche)
    - Pantalla 7: salida y puesta del sol, ventanas de linea gris (-6 a +6 grados)
    y altura actual del sol, calculadas en local para el locator IM68mu
2026-10-08 v0.5c: estacion en NVS, pantalla de configuracion y portal ampliado
    - Indicativo y locator en NVS (espacio mr_estacion); se usan en tramas Duo y pantalla sol
    - Borrar estadisticas solo borra estadisticas (conserva entrenador, estacion y WiFi)
    - Pantalla 8: datos de la estacion, abrir portal y reset de fabrica con confirmacion
    - Portal: pagina Setup con indicativo, locator y hora local manual
2026-10-08 v0.5e: interfaz reorganizada y bateria mas precisa
    - Se elimina la pantalla de debug; LoRa y bateria pasan a Configuracion
    - Pantallas con constantes PANTALLA_* y funciones de dibujo con nombre
    - Cabecera con el nombre corto de cada pantalla; "- : opc" si hay opciones
    - Bateria: atenuacion 2.5 dB, divisor x4.9 y porcentaje con curva Li-ion
    - Diagnostico de bateria al arranque (temporal, hasta calibrar con polimetro)
2026-10-08 Renombra Claude.md a CLAUDE.md y anota v0.5e en las dos placas
    Claude Code busca CLAUDE.md; en sistemas que distinguen mayusculas el nombre
    anterior podria no cargarse.
2026-10-08 v0.6b: motor CW en una tarea FreeRTOS; Duo sin startReceive() al acabar cada emision
2026-10-08 v0.6c: palas en GPIO4/5 y salida KEY en GPIO2; esquema del prototipo en protoboard
    - KEY_OUT_PIN (GPIO2) en BAJO al principio de setup(), sin pull-up
    - docs/esquema_protoboard.pdf y su generador docs/gen_esquema.py
    - CLAUDE.md: mapa de pines del prototipo
2026-10-09 CLAUDE.md: posicion fisica de los pines y pads 17/18 de la cara inferior
2026-10-09 v0.6g: el aparato pasa a llamarse Chispas; bateria con umbral 2,6 V y suavizado
    - Pantalla de inicio: CHISPAS grande en un marco y "de <indicativo> v<version>"
    - Portal Chispas-XXXX (clave chispas73), user-agent y mensaje de arranque con el nombre nuevo
    - Esquema del prototipo regenerado con el nombre nuevo
    - Bateria: "sin bateria" por debajo de 2,6 V (dato de Meshtastic, sin comprobar) y suavizado al 50 %
    - El espacio NVS mr_morse se mantiene para no perder lo guardado
2026-10-09 v0.6h: encoder KY-040 en 19/20/48 (giro = foco, pulsar = ejecutar, pulsar y girar = editar valor)
    - Lectura por interrupcion con tabla de cuadratura; pulsadores PRG y eje con antirrebote
    - Entorno prueba_pines (pruebas/prueba_pines.cpp) para probar pines sin tocar el firmware
    - QSO: pines de palas G4/G5
2026-10-09 v0.6k: manejo solo con el encoder; PRG corto = atras; paginas visibles en PROP y POTA
    - v0.6i: pies sin ayudas del PRG; acciones de pulsacion larga pasan a opciones con foco; entrarEnPantalla()
    - v0.6j: pagina en la barra de PROP y POTA, opcion "mas >"; PROP sin "wifi"; CONF: "webconf"
    - v0.6k: linea de spot POTA en 21 caracteres; foco en ant./sig. segun el sentido del cambio de pantalla
2026-10-09 CLAUDE.md: quita un byte nulo de la nota sobre heredocs
2026-10-09 v0.6m: cara de Chispas (salvapantallas animado de Inicio); Koch: letra nueva al 25 %
    - Ojos y boca con primitivas; gestos: contenta, risa, >_<, guino, picara, nerviosa, sorpresa, cansada y dormida
    - La letra nueva de cada leccion sale el 25 % de las veces (tambien en Duo)
    - CLAUDE.md: ideas con el encoder aparcadas para mas adelante
2026-10-09 CLAUDE.md: propuestas de consumo y recursos para estudiar mas adelante
2026-10-09 v0.6n: deteccion de bateria desconectada con USB por la dispersion de la lectura
    Sin bateria el cargador oscila (dispersion 0,25 V frente a 0,002 V con bateria):
    umbral de 0,08 V sobre una rafaga de 200 lecturas. Probado en las dos placas.
    Entorno prueba_bateria para medirlo.
2026-10-09 CLAUDE.md: medida de GPIO2 en arranque y reset; pull-down de 10k recomendado
2026-10-09 v0.7a: keyer iambico (modos A y B) con descodificacion de lo manipulado
    - Tarea FreeRTOS que lee las palas (GPIO4/5) cada 1 ms; memoria de pala segun el modo
    - Pantalla CW > KEYER: wpm, modo, palas normales/invertidas, borrar y volver; texto descodificado
    - Configuracion en NVS (kwpm, kmodob, kinv)
2026-10-09 v0.7b: modo Echo (Chispas emite letras de la leccion Koch y se repiten con las palas)
    - Pantalla CW > ECHO: largo 1-5, ver la letra antes, repetir; marcador de aciertos
    - Tras un fallo muestra lo manipulado y el codigo correcto, y repite el mismo reto
    - La pantalla CW pierde el titulo para que quepan cuatro opciones
2026-10-09 v0.7e: pantalla CW al estilo LoRa (KOCH, KEYER, ECHO); webconf: hora UTC en la cabecera
    - Titulo en negativo y tres opciones; estadisticas como ultima opcion dentro de KOCH
    - Casilla en la pagina Setup del portal para mostrar la hora en UTC (12:05Z); sin probar
2026-10-09 v0.7k: webconf con QR, portal en castellano, hora espanola y UTC; WiFi sin portal automatico
    - Webconf muestra los datos; con el portal abierto, 'ver qr' en CONF muestra el QR de WiFi (componente qrcode de ESP-IDF)
    - Portal WiFiManager traducido (include/wm_strings_chispas.h) y hora manual en formato HH:MM DD-MM-AAAA
    - Casilla de hora UTC en la cabecera (12:05Z)
    - PROP, POTA y SOL: sin red o sin conexion, aviso fijo con 'abrir webconf' en vez de abrir el portal solo
    - SOL enciende el WiFi solo si no hay hora (NTP); sin destello de mensajes al entrar
2026-10-10 CLAUDE.md: el buzzer comprado es magnetico; piezo pedido
2026-10-10 README.md para GitHub; repositorio renombrado a CHISPAS-EA4ILN
2026-10-10 Licencias: GPL-3.0-or-later para el software y CC BY-NC-SA 4.0 para hardware y documentacion
    - LICENSE con el texto oficial de la GPL-3.0 (gnu.org) y LICENSE-HARDWARE.md
    - Cabeceras SPDX en el codigo; wm_strings_chispas.h conserva el aviso MIT de WiFiManager
    - README: insignias y seccion de licencia
2026-10-10 Locator por defecto generico (IN80dk, Madrid); CLAUDE.md sin datos personales; fuera los README de ejemplo
2026-10-10 v0.7l: la memoria del entrenador pasa a llamarse 'chispas' (se borra 'mr_morse' en el primer arranque)
2026-10-10 v0.7m: ahorro de energia (30 mA sin WiFi, antes 50) y diagnostico por serie
    - CPU a 80 MHz con el WiFi apagado (240 MHz con el encendido) y descanso de 1 ms en loop()
    - LoRa dormida fuera de Duo y QSO; WiFi apagado en CONF y SOL salvo con el portal abierto
    - OLED tenue con la cara dormida
    - [DIAG] cada minuto: memoria, pilas de las tareas, NVS y CPU
    - El borrado de 'mr_morse' solo actua si le quedan datos
2026-10-10 v0.7n: deep sleep con PRG largo (despierta con PRG) y apagado automatico tras 30 min sin uso
    - Al dormir: OLED, WiFi, LoRa y LED apagados; KEY en BAJO, Vext y divisor de bateria retenidos
    - No se duerme solo si hay practica Koch, Duo/QSO, keyer, Echo o portal abierto
    - Probado: despertar con PRG arranca normal desde flash (no entra en modo de carga)
2026-10-10 v0.7s: modo sin encoder, Echo con iniciar, radio de Duo bien despertada, brillo y apagado configurable
    - v0.7o: OLED tenue tras 1 min sin uso (salvo en CW y LoRa); apagado automatico configurable en CONF
    - v0.7p: entorno heltec_sin_encoder: el PRG hace de encoder (corta mover, larga ejecutar, muy larga dormir)
    - v0.7q: despertar el SX1262 con standby(..., true) antes de startReceive (la placa que solo escuchaba no recibia)
    - v0.7r: Echo espera a 'iniciar' en vez de emitir al entrar; no se duerme en CW ni LoRa
    - v0.7s: fuera las ultimas referencias al nombre antiguo
2026-10-10 v0.7t: la memoria de la estacion pasa a llamarse 'estacion'
    Indicativo, locator y hora UTC empiezan de cero (se configuran en webconf).
2026-10-10 v0.8a: OLED con el arranque de la v0.4e, atenuacion legible y diagnostico por serie
    - Atenuacion con contraste bajo (0x10) en vez de display.dim(), que lo ponia a 0 y parecia apagada
    - Ordenes por serie para la OLED negra: s (estado), a (AE/8D/AF), b (begin), v (corte de Vext y reinicio)
    - Las pruebas de arranque de las v0.7u-z se descartan; quedan anotadas en CLAUDE.md
2026-10-10 v0.8b: atenuacion con display.dim (contraste 0) y sin ordenes de diagnostico de la OLED por serie
2026-10-10 CLAUDE.md: OLED de la placa 1 falla tambien con bateria y sin medidor (8/10)
2026-10-10 v0.8c: captura provisional de la pantalla por serie (orden p, docs/captura_oled.py)
2026-10-10 captura_oled.py: imagenes en azul como la OLED (--color blanco opcional)
2026-10-10 v0.8d: tono configurable en CONF (400-1000 Hz); tono montado; amplificador PAM8302A pedido
    - CONF -> tono: frecTonoHz en NVS tono, pitido de prueba al editar (sin probar en placa)
    - gen_esquema.py: piezo de 16 mm, U2 PAM8302A, LS1 y R9 como pendientes (PDF sin regenerar)
    - CLAUDE.md: montaje y pruebas del tono, piezo demasiado bajo, plan del amplificador
2026-10-10 CLAUDE.md: opcion tono probada (850 Hz en la placa 1)
2026-10-10 v0.8e: tono CW por defecto a 850 Hz
2026-10-10 v0.8f: estadisticas por caracter (fallos marcados en el Koch y del Echo; letras flojas en ESTAD.)
2026-10-10 v0.8g: menu CW KOCH (RX) / ECHO (TX) / TX LIBRE; Echo con ajustes, retos y ESTAD. propios
    - Estadisticas por caracter separadas: Koch (carK) y Echo (carE); paginas MAS ERRORES y totales
    - Echo: wpm, espaciado y leccion propios, RETOS por practica y pantalla de resultado
    - Se descarta el bloque car de la v0.8f
2026-10-10 Keyer: fin de palabra a 6 puntos; opciones de los menus CW y LoRa centradas
2026-10-10 v0.9a: pantalla TRX (decodificador CW en GPIO6, OPERAR por KEY en GPIO2, QSO y memorias)
    - Decodificador: ADC1 por DMA a 8 kHz, Goertzel, umbral y velocidad adaptativos, tono fijo o AUTO, barra de nivel
    - KEY solo en OPERAR y QSO de TRX, tono local elegible y corte de seguridad a los 10 s
    - 6 memorias con {MI} y {SU}: editor con encoder o palas, y en webconf
    - Pendiente: probar GPIO2, PC817 y decodificador con el montaje
2026-10-10 v0.9b: esquema de 7 hojas (amplificador, R10), README con capturas y navegacion serie provisional
    - Esquema: tono con piezo y montaje con PAM8302A + altavoz (pendiente), R10 en KEY, textos y lista al dia; PDF regenerado
    - README: funciones, pantallas (8) y 29 capturas en docs/img (SOL y CONF con el locator generico)
    - Firmware: ordenes serie provisionales d/i/k/l/a (encoder simulado) y g (locator generico en RAM)
2026-10-10 v0.9c: hamqsl cada hora; README con foto del prototipo, aviso de desarrollo temprano, descargo y licencias
    - Propagacion de hamqsl.com cada 60 min (su autor pide no consultar el XML mas de una vez por hora)
    - README: foto del prototipo, aviso de desarrollo temprano, descargo de responsabilidad y creditos con licencias
2026-10-10 CLAUDE.md: v0.9c en la placa 1
2026-10-11 v0.9e: TUNE en OPERAR y QSO de TRX; v0.9d: limpieza de depuracion
    - TUNE: portadora continua por KEY de 1-10 s (NVS "ttune"), emitida por el motor CW
    (motorCWPortadora); se corta pulsando otra vez o con las palas. Corte de seguridad:
    duracion + 2 s mientras dura. Probado en la placa 1 con polimetro en GPIO2.
    - Pie de OPERAR y QSO: ">mem >SU >tune >salir" (dibujarPieTrx).
    - Fuera la orden serie 'g'; DEBUG_CW a 0; comentario de SPEAKER_PWM_PIN corregido.
    - CLAUDE.md: puerto COM segun el equipo, driver CP210x y aviso sobre Set-Content.
2026-10-11 Esquema: puente R-T en J4; KEY probada con la uSDR
    - J4 con puente entre anillo y punta: la uSDR manipula por el anillo; asi vale para
    emisoras de punta o de anillo, en llave recta. Probado con la uSDR (X6200 sin probar).
    - Hoja 7: paso 5 (KEY) hecho; membrete con firmware v0.9e. PDF regenerado con Chrome.
    - CLAUDE.md: KEY montada y probada; comando de Chrome para el PDF.
2026-10-11 v0.9g: CONF con CONFIG y STATUS; Echo por leccion. v0.9f: Koch total y aceleracion
    v0.9f
    - Koch: al final del listado, ">x letra >total >rep.". "total" pide solo el numero de
    fallos (con % en vivo); guarda el % de la leccion y suma a TOTALES KOCH (NVS ktcar,
    ktok) sin tocar las estadisticas por letra.
    - Aceleracion del encoder: la ISR mide el tiempo entre pasos; al girar rapido,
    ajustarValor() avanza mas en los valores con 20 o mas pasos.
    v0.9g
    - CONF: menu con CONFIG y STATUS. CONFIG: lista (ID, LOCATOR, ACELERACION, APAGADO,
    TONO, WEBCONF, FABRICA) con barra de desplazamiento; ID y locator con el editor de
    las memorias, validados como en el portal. Aceleracion NO/x2-x5 (NVS acel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
2026-10-11 v1.00b: primera release (beta)
    - Actualizacion OTA desde las releases de GitHub (CONF > CONFIG > ACTUALIZAR FW): consulta la ultima
    release (tambien beta), compara versiones, descarga el binario de su placa (con o sin encoder) y lo
    instala; TLS validado con include/certificados_github.h. Aviso diario de version nueva en PROP/POTA.
    - Menus y listas con el estilo de CONF en todas las pantallas (v0.9h): PROP, POTA y SOL con menu y
    paginas (SOL: hoy, ahora y manana); ajustes del Koch y del Echo en lista; TX LIBRE, OPERAR, QSO,
    Duo, QSO libre y DECODIFICAR con pie corto y "menu".
    - Depuracion con interruptores DEPURACION_* (a 0 en la release). Revision del codigo: variables sin
    uso, com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
2026-10-11 CLAUDE.md: OTA probada de punta a punta; captura de ACTUALIZAR FW con version nueva
2026-10-11 CLAUDE.md: placa 2 con la v1.00b
2026-10-11 Esquema: decodificador con pines de la Heltec, patillas de RV2, anillo de J3 libre y menu TONO
2026-10-11 README: capturas de la v1.01b (Inicio, CONFIG y DEPURACION)
2026-10-11 README: ejemplo de esptool con la v1.01b
2026-10-11 CLAUDE.md: pruebas a mano en las dos placas; placa 2 en la v1.01b por OTA
2026-10-11 v1.02b: refuerzo de las letras con mas errores en Koch y Echo (sin release)
    - REFUERZO NO/SUAVE/FUERTE en los ajustes del Koch y del Echo (NVS kref, eref; por defecto SUAVE).
    - Sorteo por pesos con las estadisticas del Koch y del Echo sumadas; la letra nueva sigue al 25 %.
    - Olvido gradual: a los 100 intentos de una letra, sus cuentas se dividen a la mitad.
2026-10-11 CLAUDE.md: refuerzo probado en la placa 1 (v1.02b, sin release)
2026-10-11 CLAUDE.md: decodificador montado y probado con Morse limpio; pendiente silenciador y corte de palabras
2026-10-11 Decodificador: silenciador con ruido y fin de palabra adaptativo (sin cambio de version)
    - Un tono solo empieza si supera 4x el suelo de ruido; marcas de un solo bloque descartadas;
    en AUTO solo se cambia de tono si destaca sobre la media de todos.
    - Ruido medido como suelo (baja deprisa, sube despacio): con la media normal se comia puntos.
    - Fin de palabra a 1,7x la pausa media entre letras (minimo 5 puntos).
    - Probado en la placa 1: con solo ruido no salen letras; con Morse limpio, letras correctas.
2026-10-11 CLAUDE.md: decodificador ya montado en el resumen
2026-10-11 CLAUDE.md y README: el decodificador separa bien las palabras
2026-10-11 ROADMAP.md con lo pendiente; SD del amplificador a GPIO38 en el esquema; sin KiCad ni pulsadores
2026-10-11 ROADMAP: fechas de llegada, BME280 en mano y ESP-NOW como fork de bajo coste
2026-10-11 ROADMAP: fechas de llegada corregidas (amplificador 12 oct, GPS 13 oct)
2026-10-11 v1.03b: sensor BME280 (AMBIENTE en SOL, tendencia y aviso de tormenta, altitud barometrica, {WX})
2026-10-11 README: ejemplo de esptool con la v1.03b
2026-10-11 README: capturas rehechas con la v1.03b (nuevas: AMBIENTE y STATUS > SENSOR)
2026-10-12 Pruebas: X6200 con KEY y bateria tras el decodificador correctas; placa 2 en la v1.03b
2026-10-12 Prueba de estabilidad de 8 h en POTA: sin fugas ni fragmentacion
2026-10-12 ROADMAP: bateria en [DIAG] y curva de bateria llena (por decidir)
2026-10-12 Salvapantallas configurable, CONFIG por bloques y expresiones de radioaficionado; amplificador como montaje principal en esquema y materiales (v1.05b)
2026-10-12 v1.06b: release con SALVAPANTALLAS, CONFIG por bloques y expresiones de radioaficionado
2026-10-12 CLAUDE.md: preguntar antes de subir version, fecha del estado, GPS el 13 oct y enable pendiente
2026-10-12 Plano de la placa perforada con reservas; ideas de versiones (Pro, Ultimate, Lite), web de instalacion y firmware modular
    - docs/gen_placa.py genera docs/placa_perforada.pdf y comprueba las conexiones con y sin reservas
    (trafo 600:600 con jumpers en P10, deteccion de USB, enable del GPS, C3)
    - ROADMAP: Chispas Pro (BLE, carcasa), Ultimate (palas tactiles), Lite (ESP-NOW), web de instalacion
    por USB y firmware modular
    - CLAUDE.md: placa perforada y referencia a Chispas Lite
2026-10-13 ROADMAP y CLAUDE.md: apagar el GPS por software (UBX por GPIO39) y alternativas al AO3401A
2026-10-13 ROADMAP: diseño del teclado CW por Bluetooth (NUS) para mas adelante
2026-10-13 CLAUDE.md resumido (8 KB); el detalle pasa a docs/NOTAS.md
    CLAUDE.md se carga en cada sesion: ahora solo lleva el resumen (estado, arquitectura,
    pines, reglas y pendientes) y remite a docs/NOTAS.md, que es el CLAUDE.md anterior
    completo, para el historial y el detalle. README y dos comentarios de main.cpp
    apuntan a docs/NOTAS.md.
2026-10-13 Divide main.cpp en src/parts/*.inc por areas (mismo codigo)
    main.cpp (7009 lineas, 285 KB) se corta por sus secciones en 27 trozos seguidos,
    copiados byte a byte a src/parts/<area>.inc e incluidos desde main.cpp en el mismo
    orden: una sola unidad de compilacion, sin prototipos nuevos.
    Comprobado: al juntar las partes sale el main.cpp anterior; los dos entornos dan los
    mismos RAM y flash, y los .bin solo difieren en app_elf_sha256 y en la suma y el
    SHA-256 del final de la imagen. Sin probar en placa (codigo identico).
    CLAUDE.md, NOTAS, README y ROADMAP actualizados.
2026-10-13 compilar.sh: compila los dos entornos con salida resumida
    Solo muestra el resultado, RAM y flash, errores con contexto y avisos de src/;
    la salida completa queda en .pio/compilar.log. Notas sobre las extensiones de VS Code.
2026-10-13 Repositorio fuera de OneDrive: C:\proyectos\CHISPAS-EA4ILN en cada equipo
    Pasos para migrar los otros dos equipos en NOTAS ("Repositorio").
2026-10-13 NOTAS: migracion de la carpeta de trabajo fuera de OneDrive y pasos para los otros equipos
2026-10-13 NOTAS: Settings Sync de VS Code activado en el equipo 1
2026-10-13 publicar.sh (release en tres pasos), serie.py (lector serie) y permisos compartidos de Claude Code
2026-10-13 NOTAS: gh con sesion en el equipo 1
2026-10-13 comprobar_equipo.sh, finales de linea normalizados y pasos de migracion completos
2026-10-13 Settings Sync activado en el equipo 2
2026-10-13 gh instalado con sesion en el equipo 3
2026-10-13 Settings Sync activado en el equipo 3
2026-10-13 Firmware partido en .inc probado en la placa 1; MAC de la placa 1
2026-10-13 Pendientes: enable del GPS descartado, Heltec orientada, cara de auriculares vista
2026-10-13 Encoder: SW a GPIO20 (despierta del deep sleep) y DT a GPIO48
2026-10-13 Permisos: quitar uno de un solo uso
2026-10-13 GPS: diseño de la integración y de los parques POTA cercanos, en ROADMAP
2026-10-13 Permisos: quitar los de un solo uso
2026-10-13 Permisos: quitar el último de un solo uso
2026-10-13 GPS en el firmware; HORA (UTC/LOCAL) y RELOJ en CONFIG
    - parts/gps.inc: NEO-6M en UART1 (47/39). AUSENTE sin modulo; duerme con PMREQ y se
    despierta al arrancar (tope 5 min), cada 10 min (60 s) y en STATUS > GPS. Hora UTC,
    locator (CONFIG > LOCATOR: AUTO (GPS) / MANUAL), altitud de referencia (QNH) e
    historial de presion a nivel del mar. PMREQ y GPIO39 retenido antes del deep sleep.
    - STATUS > GPS (pagina 7/7).
    - CONFIG > HORA (UTC/LOCAL) y RELOJ (fuente de la hora; pulsar = ponerla a mano).
    Fuentes GPS > WIFI > MANUAL: se queda la mas exacta; NTP parado con hora del GPS.
    Probado en placa 1: deteccion, RELOJ manual, HORA UTC/LOCAL, STATUS > GPS.
    Sin probar: el fijo (antena dentro de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
2026-10-13 Documentación del GPS y de CONFIG > HORA / RELOJ (probados en la placa 1)
2026-10-13 Release v1.07b anotada; quitar permiso de un solo uso
2026-10-13 Parques POTA cercanos: POTA > VER PARQUES con la lista de España en LittleFS
2026-10-14 Detección de USB aparcada: medidas en NOTAS y reserva R11/R12 a 47k/68k en la placa perforada
2026-10-14 Placa perforada: P5 del PAM8302A con 5 pines en el orden del módulo; GPS y BME280 comprobados
2026-10-14 OLED negra de la placa 1: diagnosticada como defecto de hardware de esa Heltec (pruebas de resets en NOTAS)
2026-10-14 Reset de fábrica: borra también la lista de parques POTA (LittleFS)
2026-10-14 v1.09b: el reset de fábrica borra también la lista de parques
2026-10-14 v1.09b instalada en las dos placas; pendiente: timeout de la OTA sin avance
2026-10-14 Placa perforada: U1 estaba en espejo; punto en E16 y puentes de KEY_A, masa y P6 corregidos
2026-10-14 Placa perforada: C2 de paso 15 mm, en vertical en C8-C14 con el cable 14 a BIAS
2026-10-15 Placa perforada montada y probada con la Heltec de la placa 2, que pasa al entorno con encoder
2026-10-15 WIFI DATOS MANUAL/AUTO: PROP, POTA y SOL solo conectan con ACTUALIZAR (aviso en pantalla); la OTA se reinicia si no avanza en 30 s
2026-10-15 v1.10: primera version final; placas renombradas (1 = perforada, 2 = protoboard); fin del soporte sin encoder tras la 1.10
2026-10-15 README: v1.10 fuera de la beta; la 1.10 es la ultima con compilacion sin encoder
2026-10-15 v1.10 instalada por OTA en la placa 1
2026-10-15 v1.10 instalada por OTA en la placa 2
2026-10-15 Pendiente: comprobar con polimetro la lectura de bateria de la placa 1
2026-10-15 NOTAS: bateria de la placa 1 a 4,08 V sin USB tras la carga
2026-10-15 NOTAS: pasos en falso del encoder de la placa 1 por mal contacto de DT
2026-10-15 Placa perforada: P1 en el orden del KY-040 (cable recto); encoder de la placa 1 sin resolver
    P1 pasa a CLK, DT, SW, +, GND; SW por el cable aislado 15. La placa 1 sigue con
    CLK, SW, DT (cable cruzado). NOTAS: pruebas del encoder con traza (GPS y
    decodificador descartados).
2026-10-15 PCB: librería KiCad con las piezas LCSC (PAM8302A, PC817 SMD, PJ-307, RK09, 3296W) y buscador del catálogo de JLCPCB
2026-10-15 PCB: simbolo y huella de la Heltec V3 en zocalos (gen_heltec.py)
2026-10-15 PCB: esquema, bloque de la Heltec con etiquetas y pines sin usar
2026-10-15 PCB: excluir el historial local de KiCad (hardware/.history)
2026-10-15 PCB: bloque KEY (en curso) y tipos de pin corregidos en los simbolos importados (tipos_pines.py)
2026-10-15 PCB: bloque KEY terminado
2026-10-15 PCB: palas con filtro de 10 nF, conectores JST-XH (encoder, GPS, BME280) y tira de pines libres
2026-10-15 PCB: bloque de audio (volumen, auriculares y PAM8302A integrado)
2026-10-15 PCB: esquema completo (decodificador con puentes para trafo; ERC sin avisos)
2026-10-15 PCB: placa de 90x60 mm, primera colocacion (colocar.py) y agujeros de los jacks sin metalizar
2026-10-15 NOTAS y CLAUDE.md: estado de la PCB (decisiones, piezas LCSC, scripts y siguiente paso)
2026-10-15 PCB: entorno de Python reproducible (entorno.sh), importar_lcsc.sh, revisar.sh y skill pcb
2026-10-15 PCB: encoder Bourns PEC11R-4230F-S0024 en la placa (24/24, eje 30 mm) con el filtro RC de Bourns; tipos_pines: pasivos por defecto
2026-10-15 PCB: encoder U4 junto a la Heltec con sus filtros; BME280 y GPS al borde derecho; tira de pines delante
2026-10-15 PCB: jacks con el cañon asomando 1,65 mm; NOTAS: encoder en placa y requisitos de la caja
2026-10-15 PCB: rutar.py (Freerouting + planos de masa, cosido y zona aislada del KEY) y freerouting.sh (Java 25 y jar portatiles); PC817 girado 180
2026-10-15 PCB: placa rutada con Freerouting, planos de masa en las dos caras, 116 vias de cosido y zona aislada del KEY (DRC: 0 sin conectar, solo serigrafia)
2026-10-15 NOTAS: estado de la PCB tras el rutado
2026-10-15 PCB: serigrafia (nombres de conectores, nota del trafo, AUX; datos, licencia y JLCJLCJLCJLC por detras) con serigrafia.py
2026-10-15 PCB: serigrafia KEY -> PTT y PALAS -> KEYER
2026-10-15 PCB: serigrafia PTT -> KEY OUT
2026-10-15 PCB: serigrafia PTT -> KEY OUT y KEYER -> KEY IN
2026-10-15 PCB: fabricar.py y archivos del pedido (Gerber, BOM, CPL, compra LCSC); NOTAS y skill al dia
2026-10-15 PCB: CPL con D1/D2 girados 180 (pin 1 al reves en la vista previa de JLCPCB)
2026-10-15 PCB: pedido de 10 placas (compra_lcsc.csv para 10); NOTAS al dia
2026-10-15 PCB: CPL sin giro en D1/D2 (la correccion de 180 los dejaba al reves: se juzga por la raya del catodo, no por el punto rosa)
2026-10-15 PCB: pedido de 5 placas (fabricar.py por defecto 5, compra_lcsc.csv); POTA con fijo del GPS probado; encoder de la placa 1 arreglado (cable Dupont)
2026-10-15 PCB: pedido a JLCPCB pagado (5 placas); siguiente, LCSC combinado
2026-10-15 PCB: pedido a LCSC hecho y combinado; R7 al CTR R09710NS (C18213426), el ALPS sin stock
2026-10-15 Pila del motor CW tras Duo medida: 3148 B libres de 4096 (v1.10)
2026-10-15 Bateria: factor unico 4,985 (calibrado con polimetro en la placa 1; antes 4,9)
2026-10-15 v1.20: fuera la version sin encoder (entorno, binario y codigo SIN_ENCODER); pendientes cerrados
2026-10-15 ROADMAP al dia (v1.20): pruebas hechas y descartadas, PCB en curso, sin variante sin encoder
2026-10-15 Reinicio de la OTA sin avance probado (placa 2, corte al 40 %); placa 2 en la v1.20 por OTA
2026-10-15 Web de instalacion por USB (ESP Web Tools en GitHub Pages): conserva la NVS salvo que se pida borrar
2026-10-15 Web de instalacion documentada (README, NOTAS, ROADMAP, CLAUDE.md)
2026-10-15 Web de instalacion: aspecto nuevo (oscura, OLED con capturas, pasos, funciones y ayuda); probada en la placa 1
2026-10-15 Captura de Inicio rehecha con la v1.20 (placa 1)
2026-10-15 Web de instalacion: sello del despliegue en manifiesto, firmware y capturas (cache de 10 min de GitHub Pages)
2026-10-15 NOTAS: sello contra la cache de GitHub Pages
2026-10-15 ROADMAP: idea aparcada de despertar y pitar a distancia (BLE o LoRa)
2026-10-15 Bateria: tope del 100 % en 4,15 V y tension y % en la linea [DIAG]
2026-10-15 Koch con indicativos y QSO POTA (ajuste TEXTO) y ritmo de la manipulacion en TX LIBRE (menu > RITMO)
2026-10-15 Koch: indicativos emitidos dos veces y pausa entre grupos de 3 s
2026-10-15 CW > qso sim: simulador de QSO POTA (Chispas de activador, tu de cazador con las palas) (sin probar en placa)
2026-10-16 qso sim: ajuste QSB (NO, SUAVE, FUERTE) bajando el ciclo del PWM del tono mientras emite el activador (sin probar en placa)
2026-10-16 Prueba de audio sintetizado por sigma-delta en GPIO7: tono, ruido, chasquidos, interferencia y QSB (pruebas/prueba_audio)
2026-10-16 prueba_audio: cuadrada suavizada (w), medida del coste de la ISR (x), CPU (u) y valores elegidos de oido
2026-10-16 NOTAS y CLAUDE.md: Duo TEXTO, qso sim y prueba de audio sigma-delta (resultados y plan)
2026-10-16 Audio sintetizado por sigma-delta en GPIO7 (adios al PWM) y RUIDO, TORMENTA y QRM en el simulador de QSO (cargado en la placa 1, sin oir)
2026-10-16 NOTAS, CLAUDE.md y README: audio sigma-delta probado de oido en la placa 1, decodificador y auricular izquierdo pendientes
2026-10-16 v1.30b: QSO SIM como tercera opcion del menu CW y tx libre en el pie; auricular izquierdo de la placa 1 (T y TN cruzados)
2026-10-16 Web de instalacion: selector Estable / Beta (la beta si es posterior a la ultima final), novedades de la 1.30b y capturas de CW y QSO SIM
2026-10-16 v1.30b publicada (beta); web con estable y beta (regla de etiquetas v* en el entorno github-pages)
2026-10-16 Web: pagina de hardware (fases, piezas, pines y PCB sin probar) con imagenes de KiCad (imagenes_web.sh)
2026-10-16 Web de hardware: foto de la placa perforada
2026-10-16 README: enlace a la pagina de hardware de la web
2026-10-16 Web: portada de presentacion (Chispas, tu companero para CW y POTA); instalar pasa a su propia seccion, tras Que lleva
2026-10-16 PCB: R7 vuelve al potenciometro ALPS RK097111080J (C97444) en el esquema y la compra; el CTR solo para las 5 placas pedidas
2026-10-16 Web: portada de presentacion, Construyelo con la caja en 3D, foto de campo y pagina de funciones; CHISPAS en mayusculas
2026-10-16 Web: etiqueta Beta junto a CHISPAS y menu desplegable en el movil (GitHub a la vista)
2026-10-16 Web: "en fabricacion" en lugar de "pedida" y "carcasa" en lugar de "caja"
2026-10-18 Decodificador: fin de palabra con Farnsworth (aprende tambien de las pausas que dan espacio) y hora de la cabecera sin parpadeo (sin getLocalTime(&t, 0)); probado con W1AW en la placa 1
2026-10-18 NOTAS: prueba del decodificador con ruido (video de 80 m y RSGB GB2RS hasta VHF THERMAL); faltan los niveles altos
2026-10-18 Orden serie 'm<texto>' que simula las palas; QSO SIM probado en la placa 1 sin palas (QSO completo y caminos de error)
2026-10-18 QSO SIM: ajuste ROL (cazador/activador); con ACTIVADOR llamas tu CQ y Chispas es el cazador (indicativo parcial, rellamada, copia mal tu indicativo, AGN?); probado en la placa 1 con la orden m
2026-10-18 Web: novedades de la beta 1.31b (QSO SIM con los dos roles, decodificador con Farnsworth)
2026-10-18 v1.31b publicada (beta); orden de la web al publicar una beta en NOTAS y en el skill release
2026-10-18 NOTAS: OTA de la 1.20 a la 1.31b probado en la placa 1
2026-10-18 FW_VERSION vuelve a 1.31b (el 0.99 de una prueba se colo en el commit anterior)
2026-10-18 Web: manual de usuario (HTML y PDF) con la mascota CHISPAS
    Manual para quien no ha usado nunca un CHISPAS: introduccion al CW, primeros
    pasos, cada funcion, problemas y glosario, con capturas de la OLED y el robot
    CHISPAS en el margen. PDF A4 en docs/manual_chispas.pdf. Enlazado desde la
    barra y la portada; hardware con Inicio en la barra y enlace de vuelta.
2026-10-18 Skill manual y web/manual.sh: PDF del manual y capturas de comprobacion
    Una orden para regenerar docs/manual_chispas.pdf, ver todas las poses del
    robot y capturas por seccion o la maqueta impresa.
2026-10-18 NOTAS: Pendiente al dia (decodificador probado, instalar la beta desde la web)
2026-10-18 ROADMAP: navegacion con GPS aparcada hasta una PCB con magnetometro y acelerometro
2026-10-18 ROADMAP: CAT con el transceptor (Icom CI-V y FT-817) aparcado hasta una PCB nueva
2026-10-18 POTA: autospot desde VER PARQUES (ficha, envio a api.pota.app y aviso para renovarlo)
2026-10-18 AUTOSPOT: comentario propio (TEXTO, con el editor, guardado en NVS)
2026-10-18 v1.32b publicada; OTA 1.20 -> 1.32b probado; skill release: probar el OTA bajando a la estable
2026-10-18 Skill release: la web no se rehace si la etiqueta cae en el commit ya desplegado (paso con la 1.32b)
2026-10-18 Pantalla TIEMPO (Open-Meteo): ahora, 12 h cada 3 h y manana; AMBIENTE pasa de SOL a TIEMPO; manual, web y README
2026-10-18 v1.33b: pantalla TIEMPO; manual 1.33b y captura de SOL ahora con 3 paginas
2026-10-18 Web: novedades de la beta 1.33b (TIEMPO)
2026-10-18 Flujo de trabajo: solo se pregunta al publicar; skills release, cerrar-tarea, placa, manual y pcb sin confirmaciones intermedias; permisos y reglas contra cd y sed -i
2026-10-19 Pulsadores: un cambio solo vale si se mantiene ~1 ms (pulsaciones fantasma por diafonia con el cable del transceptor)
2026-10-19 Quitado el filtro de pulsadores (no se repite al separar los cables); queda anotado en NOTAS por si vuelve
2026-10-20 Pulsadores: repuesto el filtro de ~1 ms (volvieron las pulsaciones fantasma; probado en la placa 1)
2026-10-20 PCB: modelo 3D de la placa montada para la caja (Heltec en sus zocalos, modelo3d.py exporta hardware/3d/chispas.step)
2026-10-20 modelo3d.py: exporta con los .step de las piezas LCSC y corrige su origen (jacks y encoder salian bajo la placa)
2026-10-20 Heltec 3D: STEP de dominio publico al repositorio, pin 1 a 2,7 mm del borde del USB y pulsadores PRG/RST (posicion estimada)
2026-10-20 Heltec 3D: pin 1 a 4,76 mm del borde del USB (medido); el STEP se alinea por el contorno de la placa
2026-10-20 Heltec 3D: lamina con la zona visible de la OLED (medida), generada por gen_heltec.py
2026-10-20 Heltec 3D: alineada por los pines, sin la lamina de la zona visible; pulsadores fijos respecto a la placa real
2026-10-20 Heltec 3D: pulsadores sobre el modelo de la Heltec (3 mm de su borde del USB)
2026-10-20 Caja v1 en CadQuery (caja.py): base y tapa en STEP y STL para la PCB v1.0
2026-10-20 Caja: ventana y altura de la tapa con la pantalla del modelo, altavoz de 20 mm, columnas del compartimento unidas al suelo
2026-10-21 CLAUDE.md: pendientes de la caja
2026-10-21 Pulsaciones fantasma en TRX: hipotesis de RF y plan de pruebas para la PCB nueva
2026-10-21 Velocidad efectiva (Farnsworth) como en LCWO en lugar del espaciado en %: Koch, Duo, Echo y QSO SIM; cabecera 25/10WPM; manual, PDF, web y README
2026-10-21 captura_oled.py: busca sola el puerto del CP210x (antes COM16 fijo)
2026-10-21 Velocidad efectiva: oída igual que LCWO; fuera de pendientes
2026-10-21 v1.34b: velocidad efectiva como LCWO y filtro de pulsadores
2026-10-21 v1.34b en la placa 1 por OTA
2026-10-21 Koch: cuenta atrás de 3 s antes del primer grupo
2026-10-22 NOTAS: el CTR de R7 lleva interruptor (hoja de datos y posición de S1/S2 en la PCB)
2026-10-22 Nueva placa 2 (Heltec desnuda, v1.34b por USB); la antigua se devuelve con el firmware de Heltec
2026-10-22 NOTAS: órdenes serie activadas en la placa 2 sin encoder; BAT 95% sin batería
2026-10-22 Placa 2: firmware v1.34b de la release, órdenes serie y batería
2026-10-22 NOTAS: el BAT 95% de la placa 2 era con batería (no hay fallo)
2026-10-23 TRX: aclarar OPERAR (copiar de oído) frente a QSO (con decodificador) en manual, PDF, web y README
2026-10-23 Web: la entrada de audio se llama DECOD (no SND IN) en la portada y en funciones
2026-10-23 La entrada de audio se llama SND IN (DECOD) en web, manual, PDF y rótulo de la caja (dos líneas)
2026-10-23 CLUSTER: nodos probados (RBN, URE, VE7CC, WA9PIE) y decisiones de la fase 1, sin código
2026-10-23 CLUSTER: decisión de distancias (solo en ¿QUIÉN ME OYE?, exacta por los locators del RBN)
2026-10-23 Indicativo de fábrica EAXXXX; sin el propio no se abren OPERAR, QSO de TRX ni el autospot
2026-10-23 v1.35b: CLUSTER, indicativo de fábrica EAXXXX y cuenta atrás del Koch
2026-10-23 v1.35b publicada: novedades de la beta en la web, manual 1.35b y PDF, NOTAS y CLAUDE.md
2026-10-23 CLUSTER: ESCUCHA EN TRX (QUIÉN ME OYE sigue con el RBN mientras llamas CQ desde TRX)
2026-10-23 Cabecera: W con el WiFi encendido
2026-10-23 v1.36b: ESCUCHA EN TRX en CLUSTER y W de WiFi en la cabecera
2026-10-23 Cabecera: W de WiFi en negativo
2026-10-23 Web: volver de las listas del cluster en las novedades de la beta (v1.36b republicada)
2026-10-23 Capturas de CLUSTER con la W y el volver (manual, PDF y README)
2026-10-23 QUIÉN ME OYE probado con la emisora (7 receptores, km como DXLook); capturas reales
2026-10-23 Cabecera: L en negativo con la radio LoRa escuchando (Duo y QSO libre)
2026-10-23 v1.37b: WiFi de TRX solo en OPERAR y QSO, QUIÉN ME OYE en su menu y L de LoRa
2026-11-07 PCB: error del filtro del encoder, medido y arreglado con estaño; prueba_pines con los pines de ahora
2026-11-08 PCB: BME280 y GPS probados; pines de J2 y J3 y GPS antiguo dañado
2026-11-08 PCB: giro, palas, decodificador y auriculares probados; curva del volumen explicada
2026-11-08 PCB: curva del volumen por la carga de los auriculares; se deja y opciones para otra tirada
