ea4iln-debug/CHISPAS-EA4ILN/(notices)

Notices in the files:
README.md:
https://img.shields.io/badge/software-GPL--3.0-blue
